x0xb0x/x0xb0x.github.io/README.md

# x0xb0x.github.io
Please view on [http://x0xb0x.github.io](http://x0xb0x.github.io)

All info licensed CC-BY, all software licenced MIT.
