x0xb0x/x0xb0x.github.io/assets/images/betameter.gif

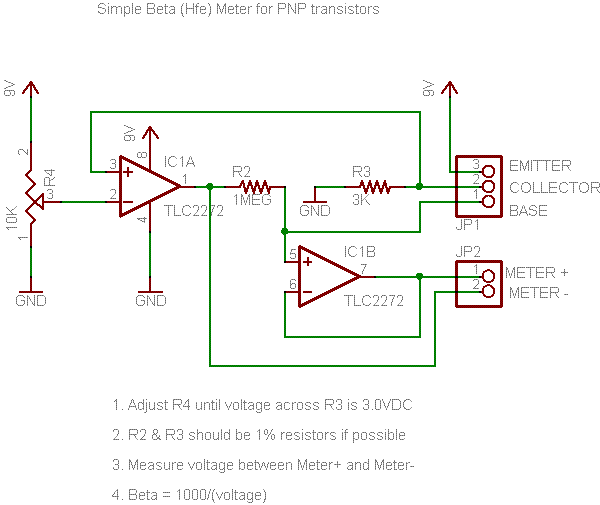
assets/images/betameter.gif
