x0xb0x/x0xb0x.github.io/assets/images/diytools/aps1.jpg

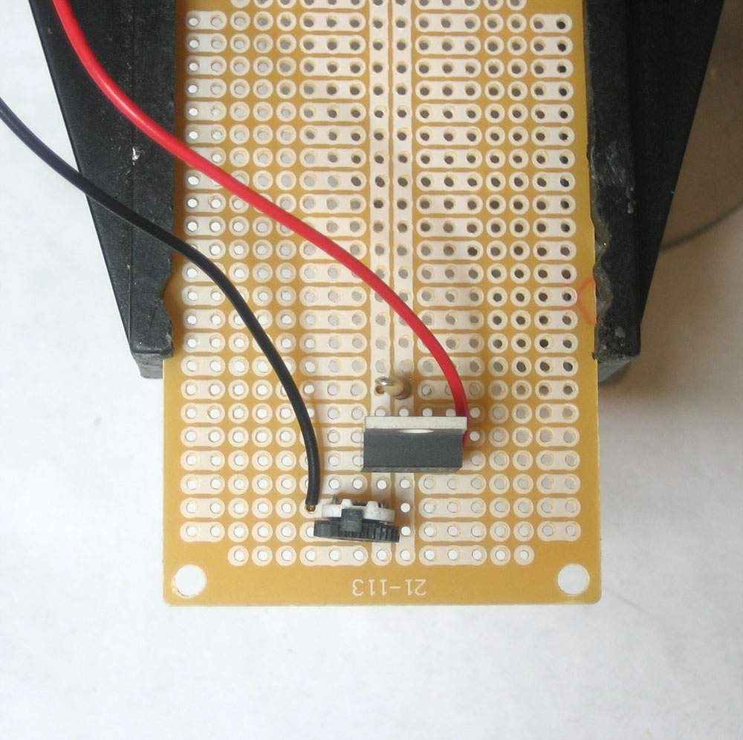
assets/images/diytools/aps1.jpg
