x0xb0x/x0xb0x.github.io/assets/images/diytools/apsparts.jpg

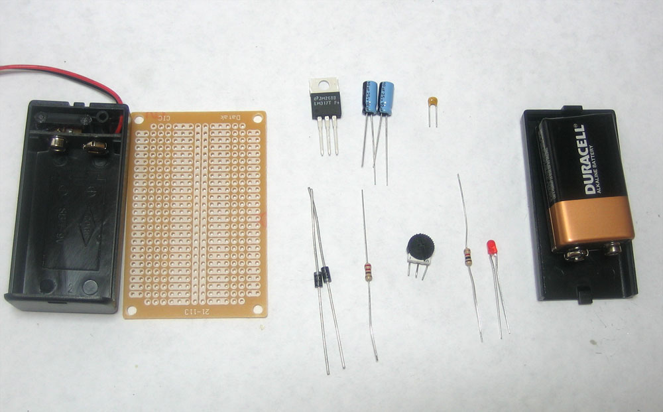
assets/images/diytools/apsparts.jpg
