x0xb0x/x0xb0x.github.io/assets/images/diytools/bandgaptest.jpg

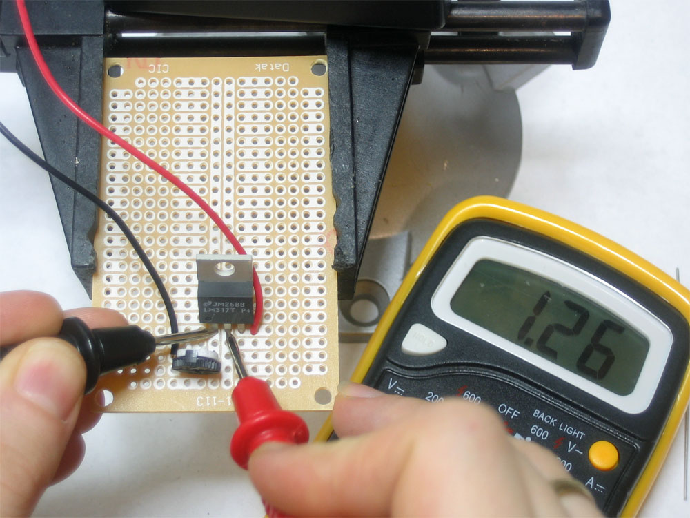
assets/images/diytools/bandgaptest.jpg
