x0xb0x/x0xb0x.github.io/assets/images/diytools/CA-2208.jpg

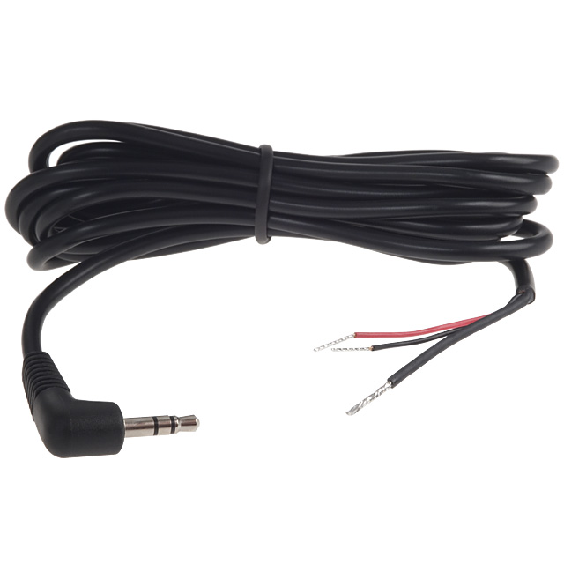
assets/images/diytools/CA-2208.jpg
