x0xb0x/x0xb0x.github.io/assets/images/diytools/done.jpg

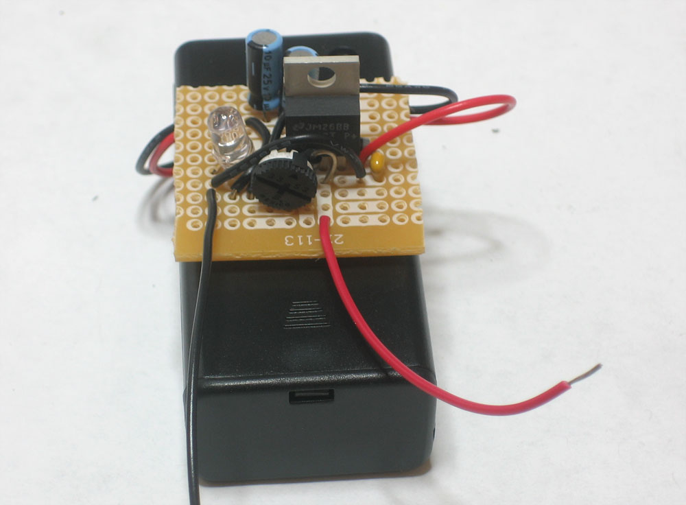
assets/images/diytools/done.jpg
