x0xb0x/x0xb0x.github.io/assets/images/diytools/highout.jpg

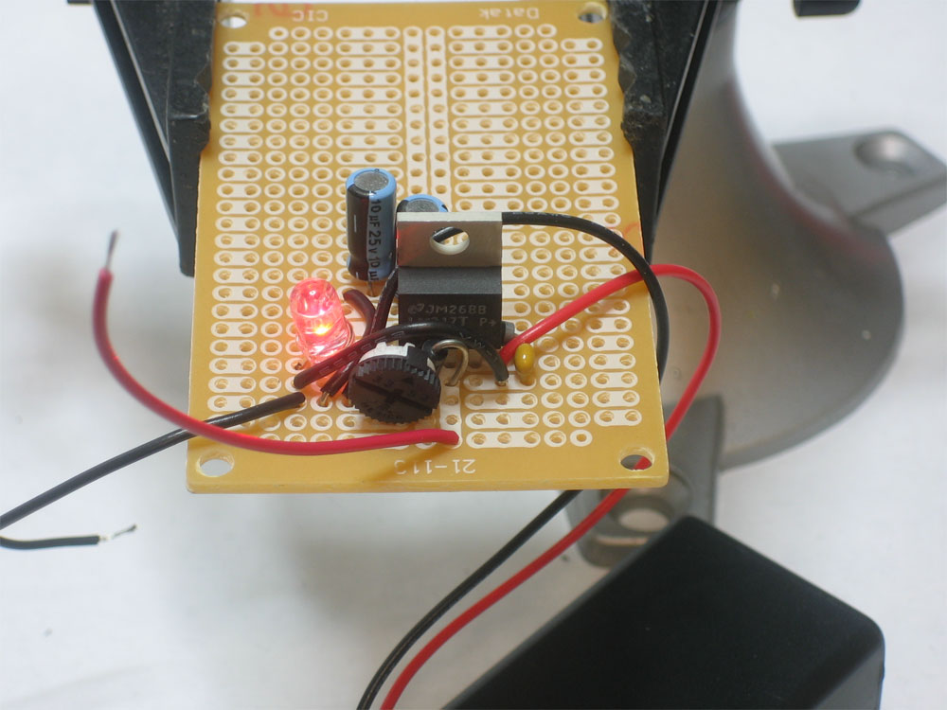
assets/images/diytools/highout.jpg
