x0xb0x/x0xb0x.github.io/assets/images/diytools/lowout.jpg

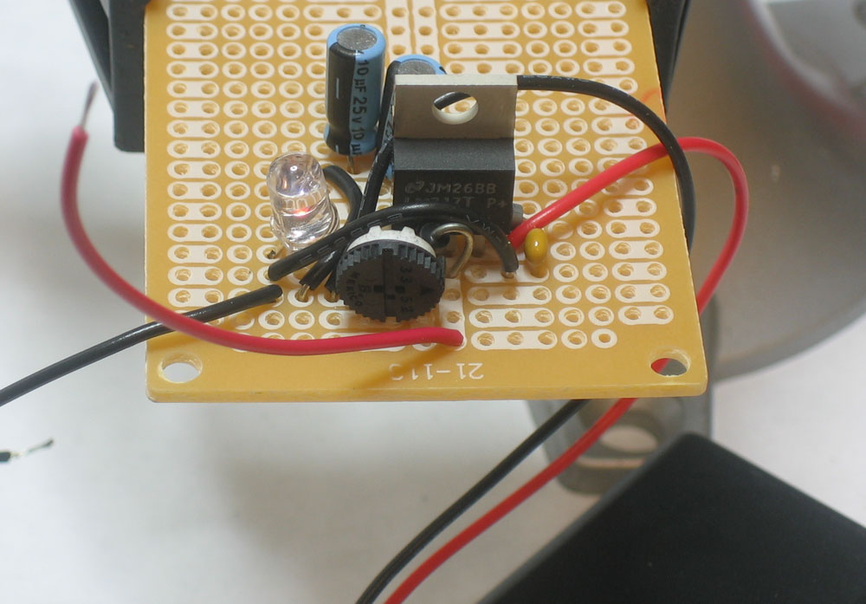
assets/images/diytools/lowout.jpg
