x0xb0x/x0xb0x.github.io/assets/images/diytools/outtest2.jpg

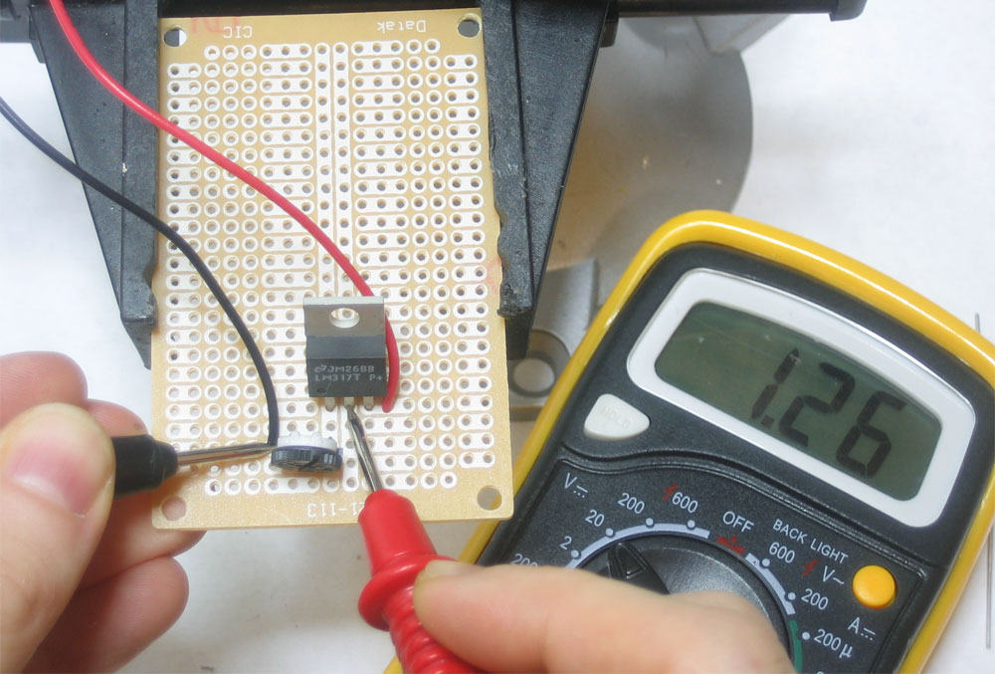
assets/images/diytools/outtest2.jpg
