x0xb0x/x0xb0x.github.io/assets/images/diytools/probe1.jpg

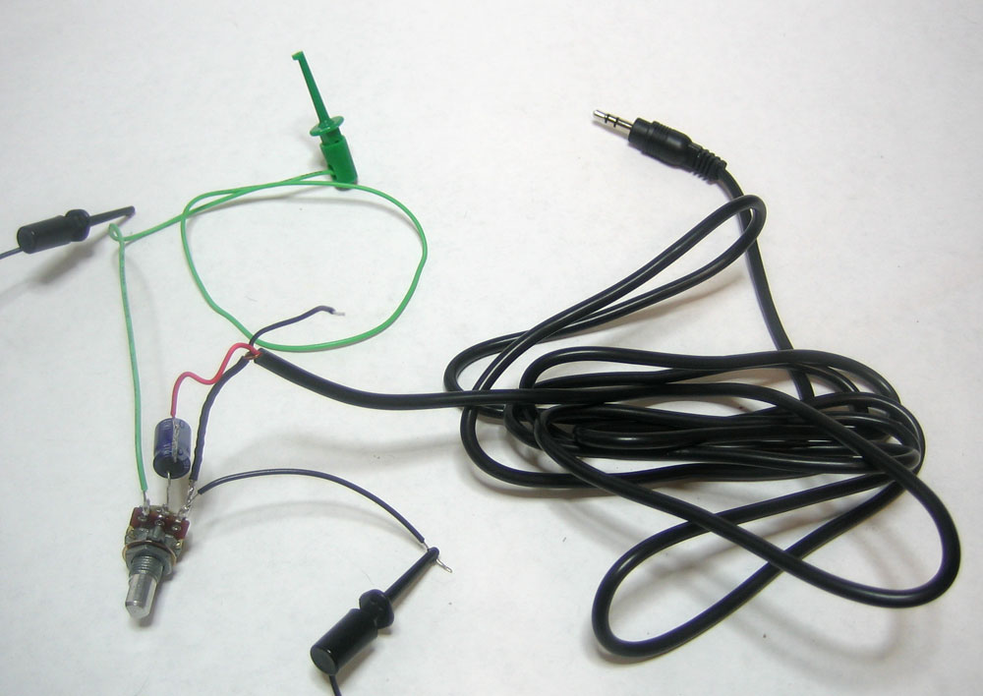
assets/images/diytools/probe1.jpg
