x0xb0x/x0xb0x.github.io/assets/images/diytools/probe2.jpg

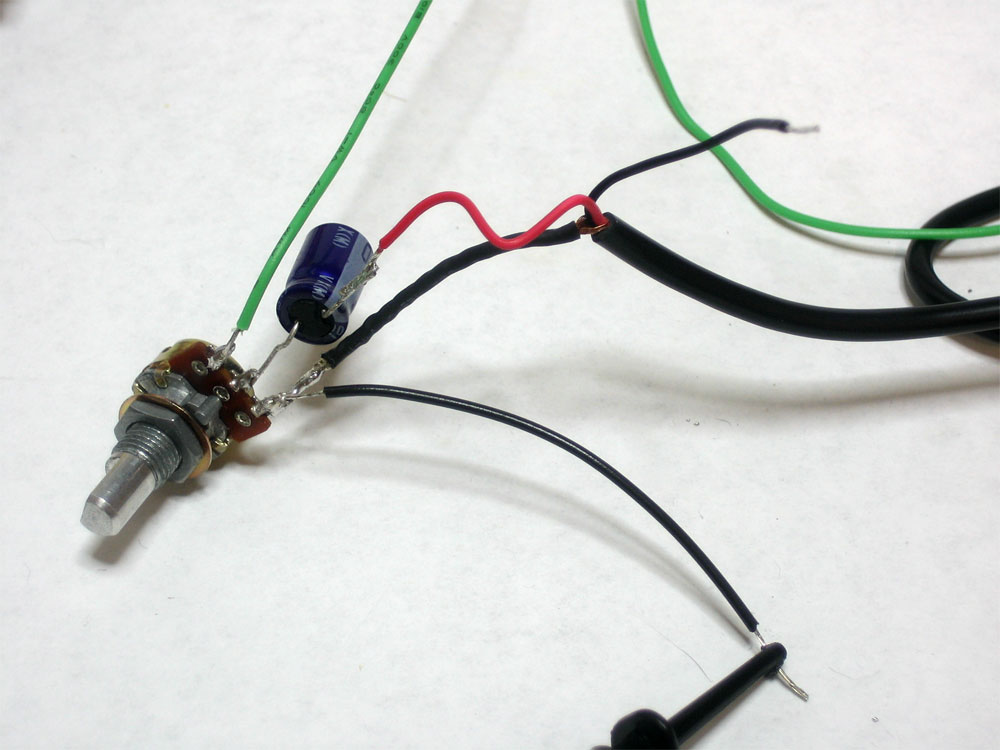
assets/images/diytools/probe2.jpg
