x0xb0x/x0xb0x.github.io/assets/images/diytools/schem.jpg

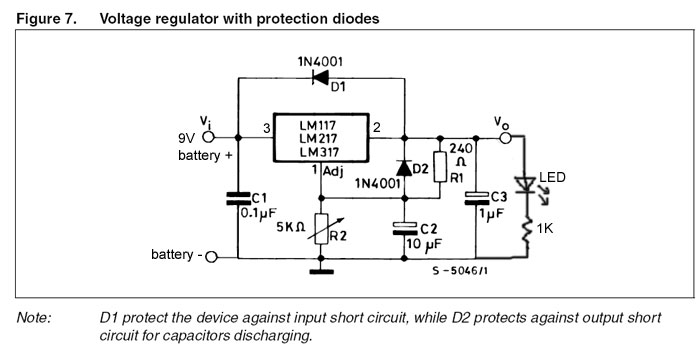
assets/images/diytools/schem.jpg
