x0xb0x/x0xb0x.github.io/assets/images/tools/100ftsolid_t.jpg

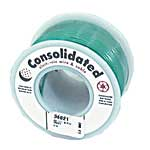
assets/images/tools/100ftsolid_t.jpg
