x0xb0x/x0xb0x.github.io/assets/images/tools/bantest_t.jpg

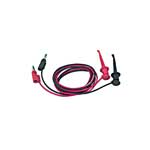
assets/images/tools/bantest_t.jpg
