x0xb0x/x0xb0x.github.io/assets/images/tools/bkprecision_875b.jpg

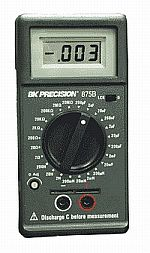
assets/images/tools/bkprecision_875b.jpg
