x0xb0x/x0xb0x.github.io/assets/images/tools/dialcalipers_t.jpg

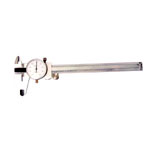
assets/images/tools/dialcalipers_t.jpg
