x0xb0x/x0xb0x.github.io/assets/images/tools/esdtweezers_t.jpg

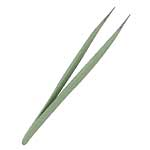
assets/images/tools/esdtweezers_t.jpg
