x0xb0x/x0xb0x.github.io/assets/images/tools/flush.jpg

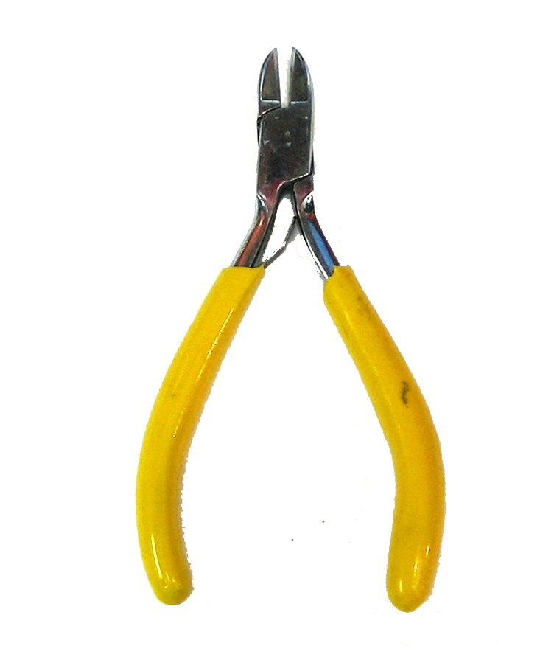
assets/images/tools/flush.jpg
