x0xb0x/x0xb0x.github.io/assets/images/tools/heatgun_t.jpg

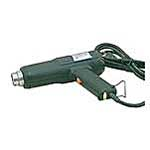
assets/images/tools/heatgun_t.jpg
