x0xb0x/x0xb0x.github.io/assets/images/tools/heatgunattach_t.jpg

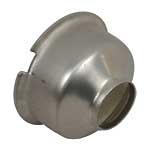
assets/images/tools/heatgunattach_t.jpg
