x0xb0x/x0xb0x.github.io/assets/images/tools/HFshear_t.gif

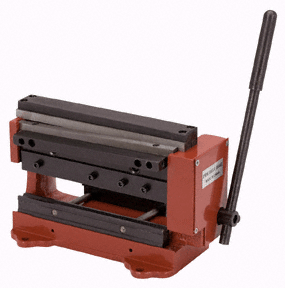
assets/images/tools/HFshear_t.gif
