x0xb0x/x0xb0x.github.io/assets/images/tools/icextractor.jpg

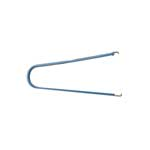
assets/images/tools/icextractor.jpg
