x0xb0x/x0xb0x.github.io/assets/images/tools/metcal200sp.jpg

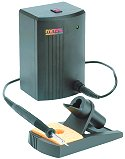
assets/images/tools/metcal200sp.jpg
