x0xb0x/x0xb0x.github.io/assets/images/tools/metcalmx500.jpg

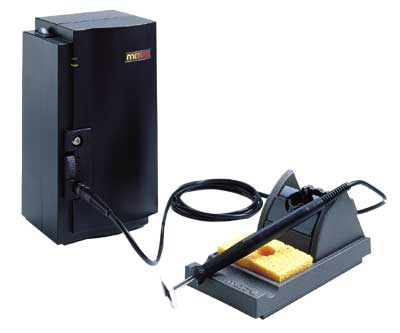
assets/images/tools/metcalmx500.jpg
