x0xb0x/x0xb0x.github.io/assets/images/tools/meter.jpg

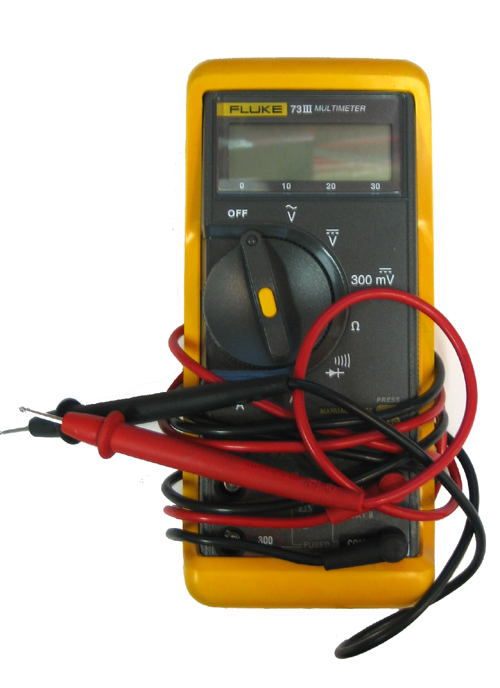
assets/images/tools/meter.jpg
