x0xb0x/x0xb0x.github.io/assets/images/tools/needlenose.jpg

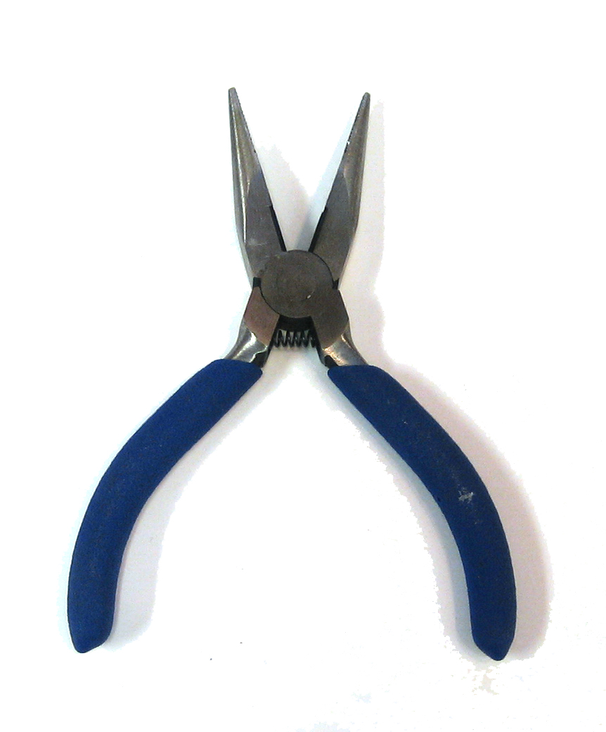
assets/images/tools/needlenose.jpg
