x0xb0x/x0xb0x.github.io/assets/images/tools/nibbler_t.jpg

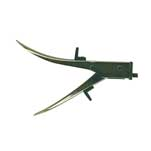
assets/images/tools/nibbler_t.jpg
