x0xb0x/x0xb0x.github.io/assets/images/tools/sucker.jpg

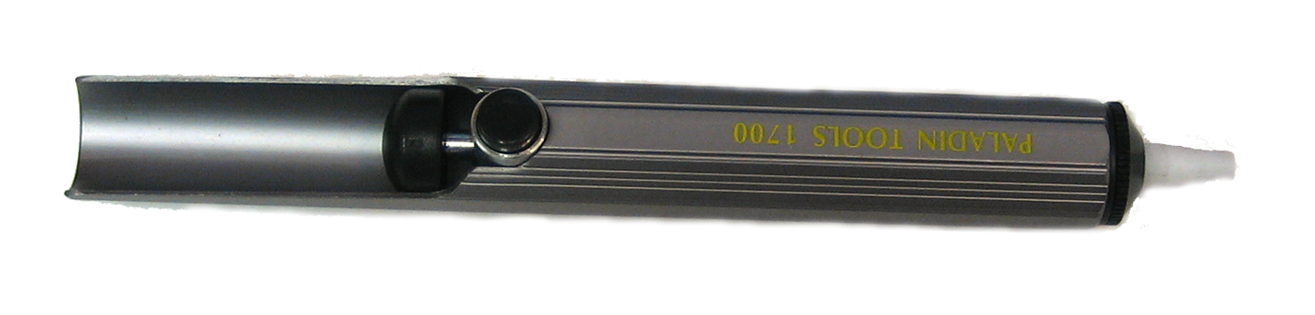
assets/images/tools/sucker.jpg
