x0xb0x/x0xb0x.github.io/assets/images/tools/tiptin_t.jpg

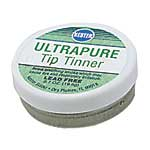
assets/images/tools/tiptin_t.jpg
