x0xb0x/x0xb0x.github.io/assets/images/tools/ttechshear.jpg

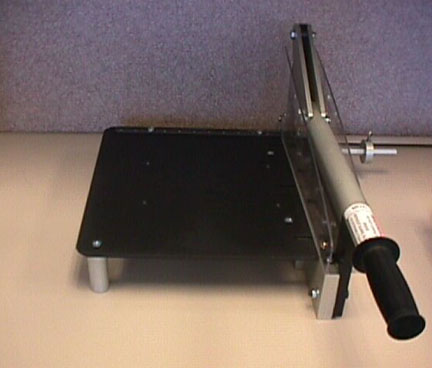
assets/images/tools/ttechshear.jpg
