x0xb0x/x0xb0x.github.io/assets/images/tools/tweezers.jpg

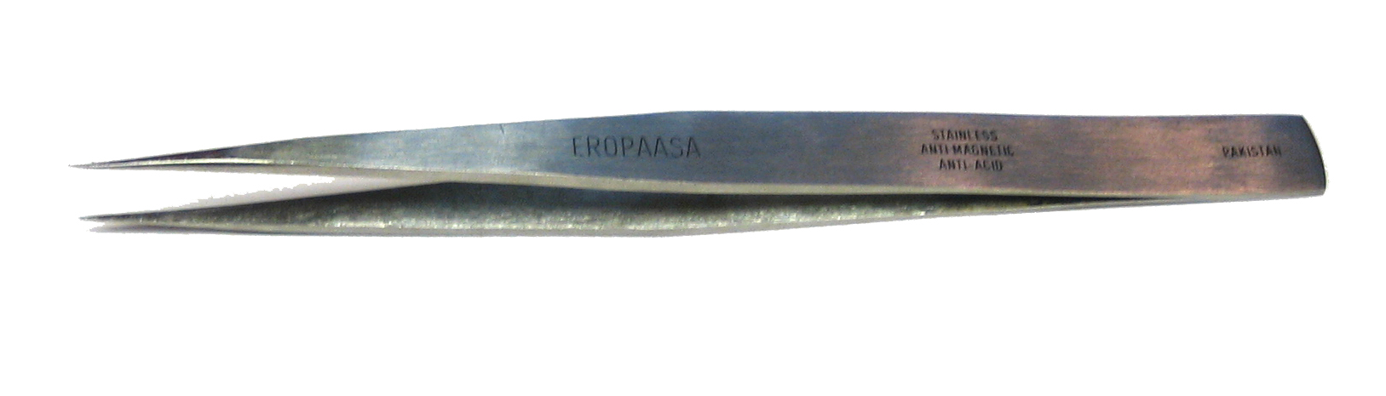
assets/images/tools/tweezers.jpg
