x0xb0x/x0xb0x.github.io/assets/images/tools/univcrimp_t.jpg

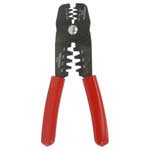
assets/images/tools/univcrimp_t.jpg
