x0xb0x/x0xb0x.github.io/assets/images/tools/wihaprecscrewdriverset_t.jpg

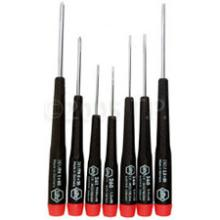
assets/images/tools/wihaprecscrewdriverset_t.jpg
