x0xb0x/x0xb0x.github.io/assets/images/tools/wirecutterstripper_t.jpg

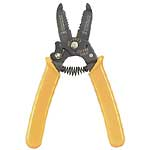
assets/images/tools/wirecutterstripper_t.jpg
