x0xb0x/x0xb0x.github.io/assets/images/tools/xytronics.jpg

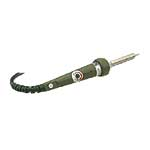
assets/images/tools/xytronics.jpg
