x0xb0x/x0xb0x.github.io/assets/images/x0xb0x/fab/ps/53adjustmax.jpg

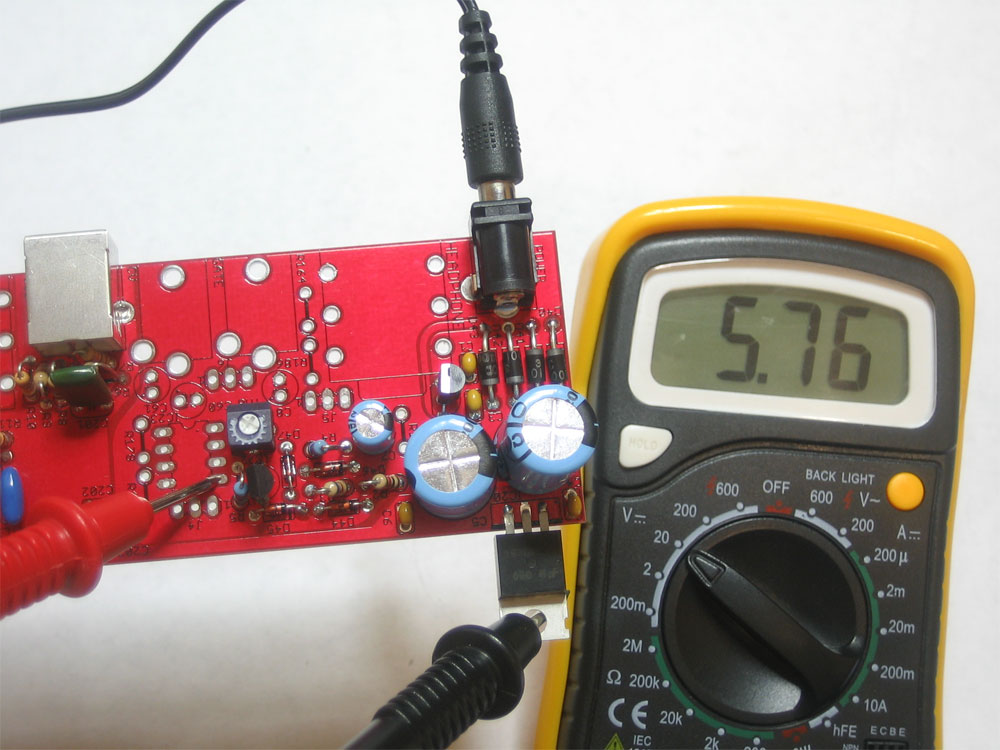
assets/images/x0xb0x/fab/ps/53adjustmax.jpg
