x0xb0x/x0xb0x.github.io/assets/images/x0xb0x/fab/ps/finalplace.jpg

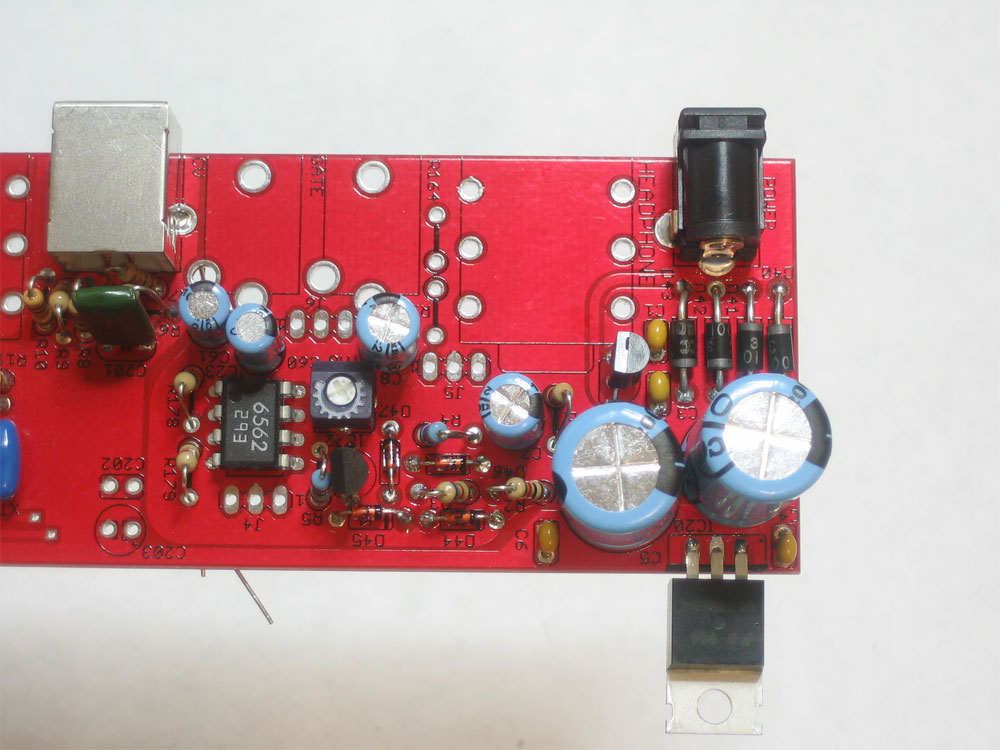
assets/images/x0xb0x/fab/ps/finalplace.jpg
