x0xb0x/x0xb0x.github.io/assets/images/x0xb0x/fab/vco/cvtest.jpg

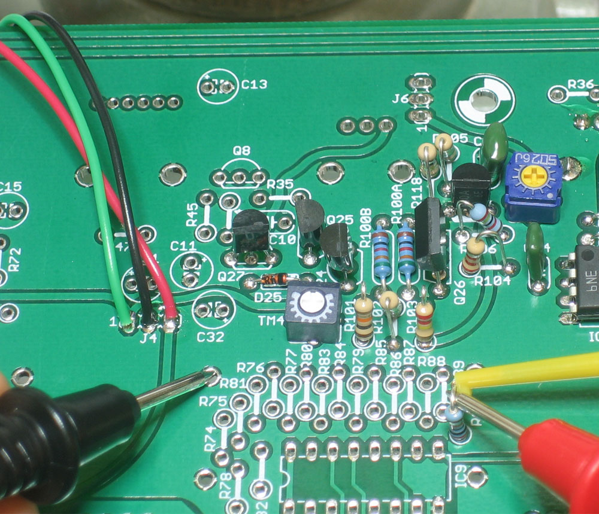
assets/images/x0xb0x/fab/vco/cvtest.jpg
