x0xb0x/x0xb0x.github.io/assets/images/x0xb0x/fab/vco/ready.jpg

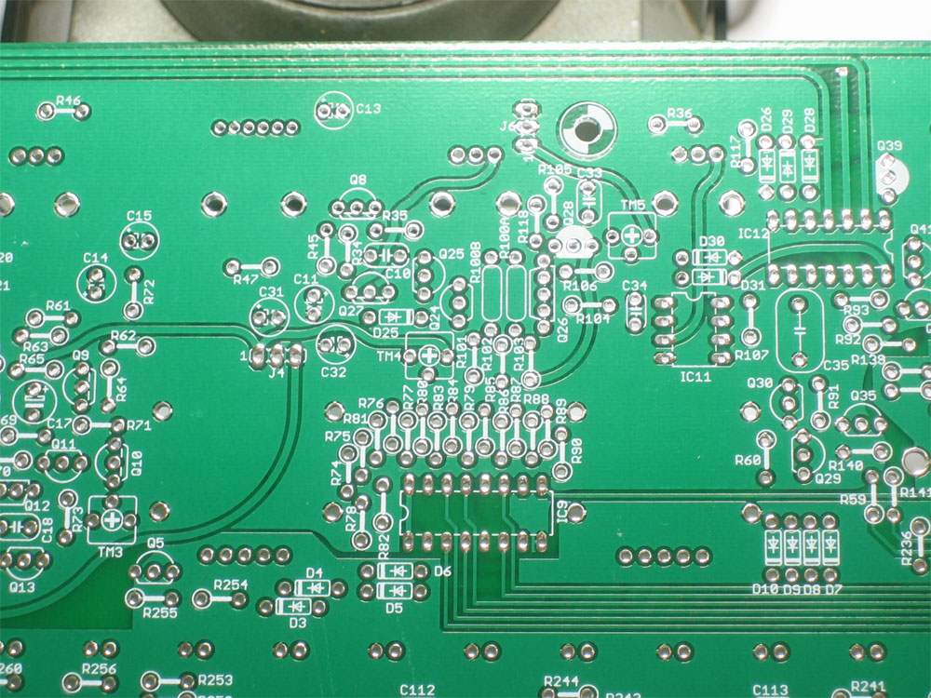
assets/images/x0xb0x/fab/vco/ready.jpg
