x0xb0x/x0xb0x.github.io/assets/images/x0xb0x/fab/vco/squaremeter.jpg

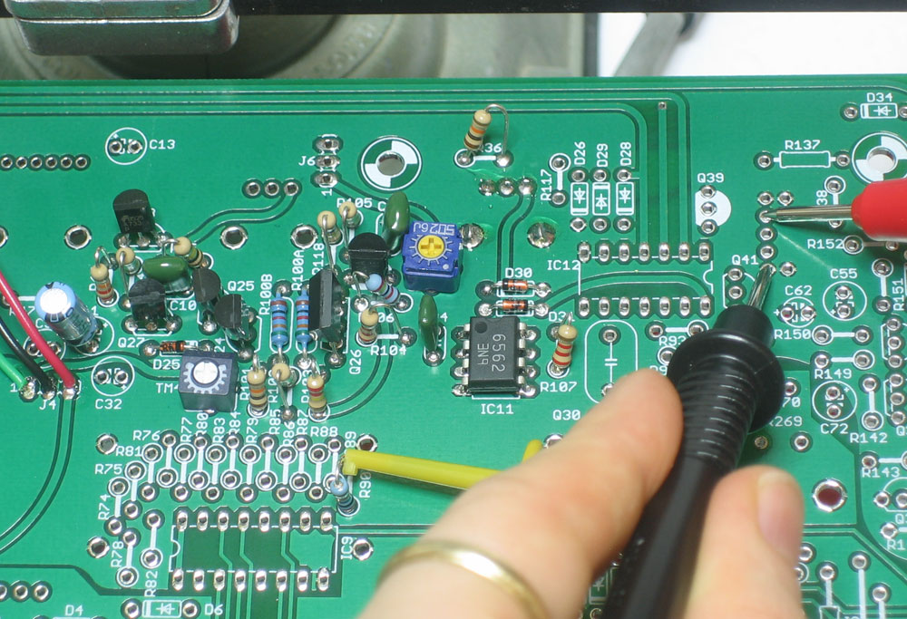
assets/images/x0xb0x/fab/vco/squaremeter.jpg
