x0xb0x/x0xb0x.github.io/assets/images/x0xb0x/fab/vco/vco1side.jpg

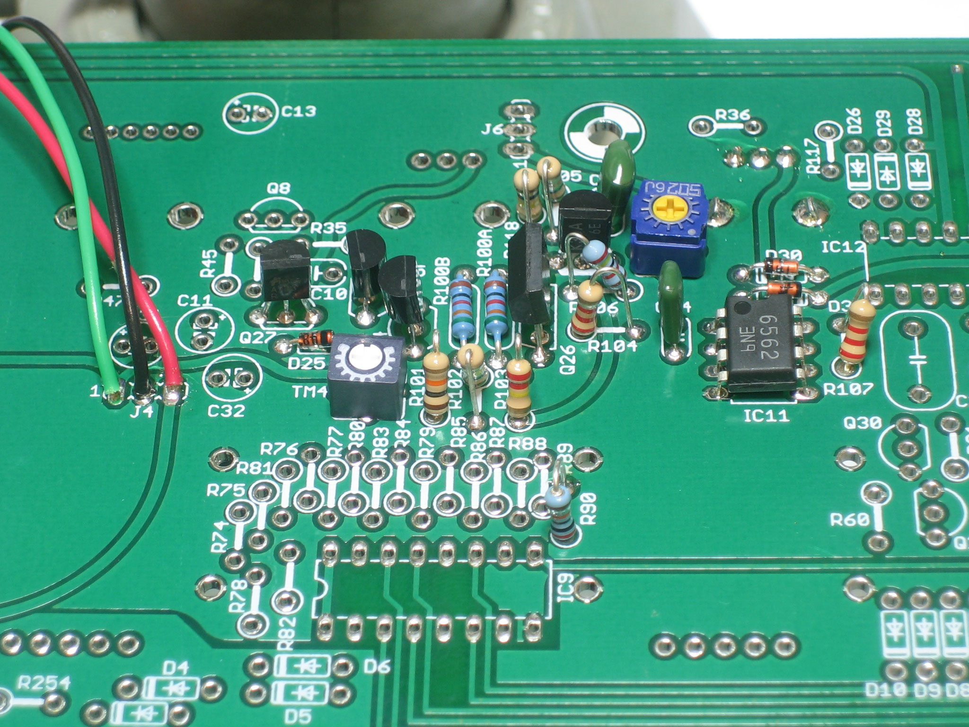
assets/images/x0xb0x/fab/vco/vco1side.jpg
