x0xb0x/x0xb0x.github.io/assets/images/x0xb0x/gallery/x0x515-3.jpg

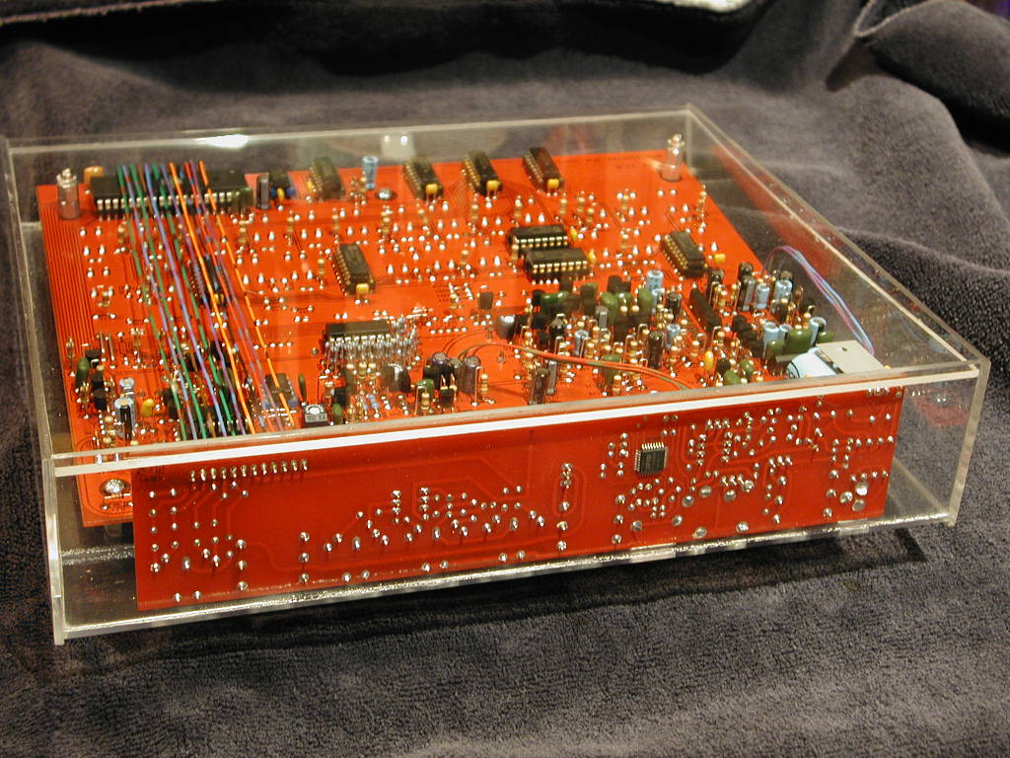
assets/images/x0xb0x/gallery/x0x515-3.jpg
