x0xb0x/x0xb0x.github.io/assets/images/x0xb0x/shorts.jpg

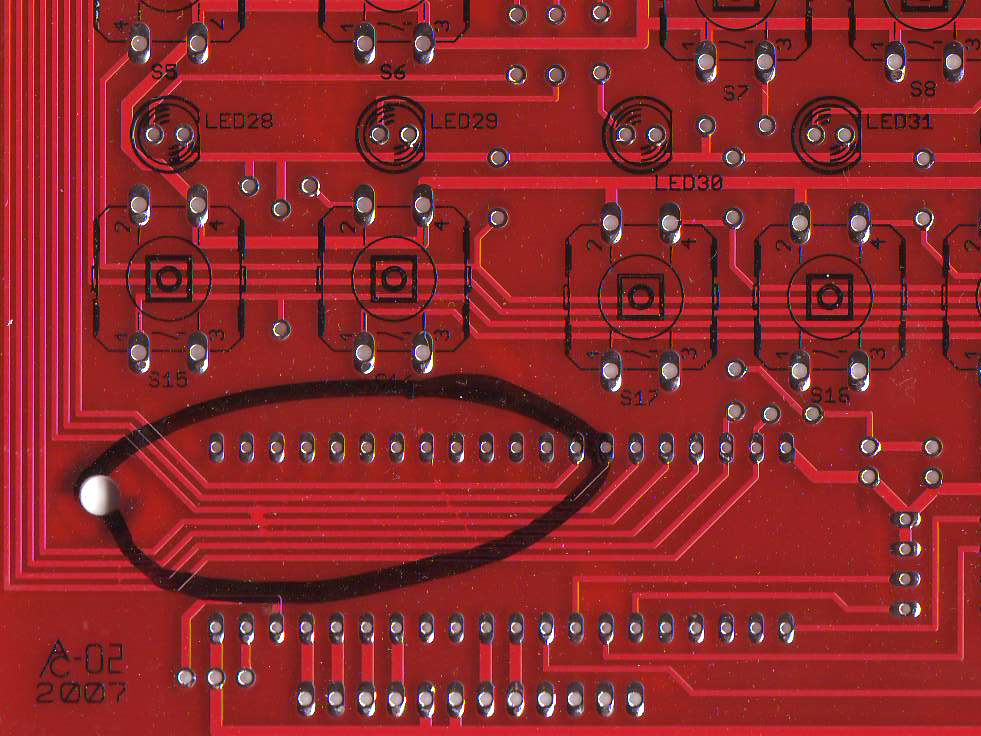
assets/images/x0xb0x/shorts.jpg
