x0xb0x/x0xb0x.github.io/assets/media/x0xb0x/ioboard release v1_0.png

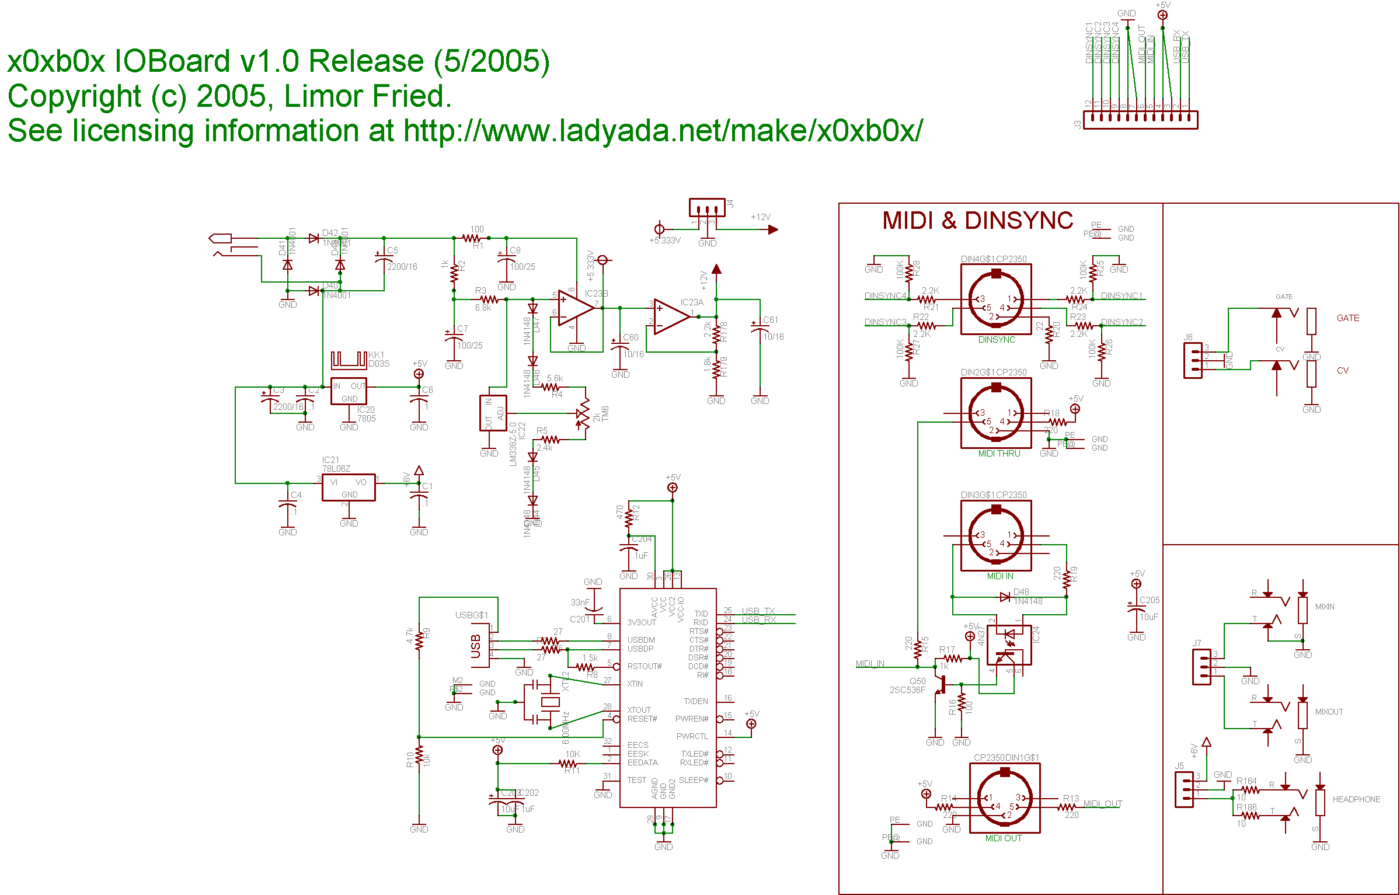
assets/media/x0xb0x/ioboard release v1_0.png
