x0xb0x/x0xb0x.github.io/assets/media/x0xb0x/mainboard_beta.png

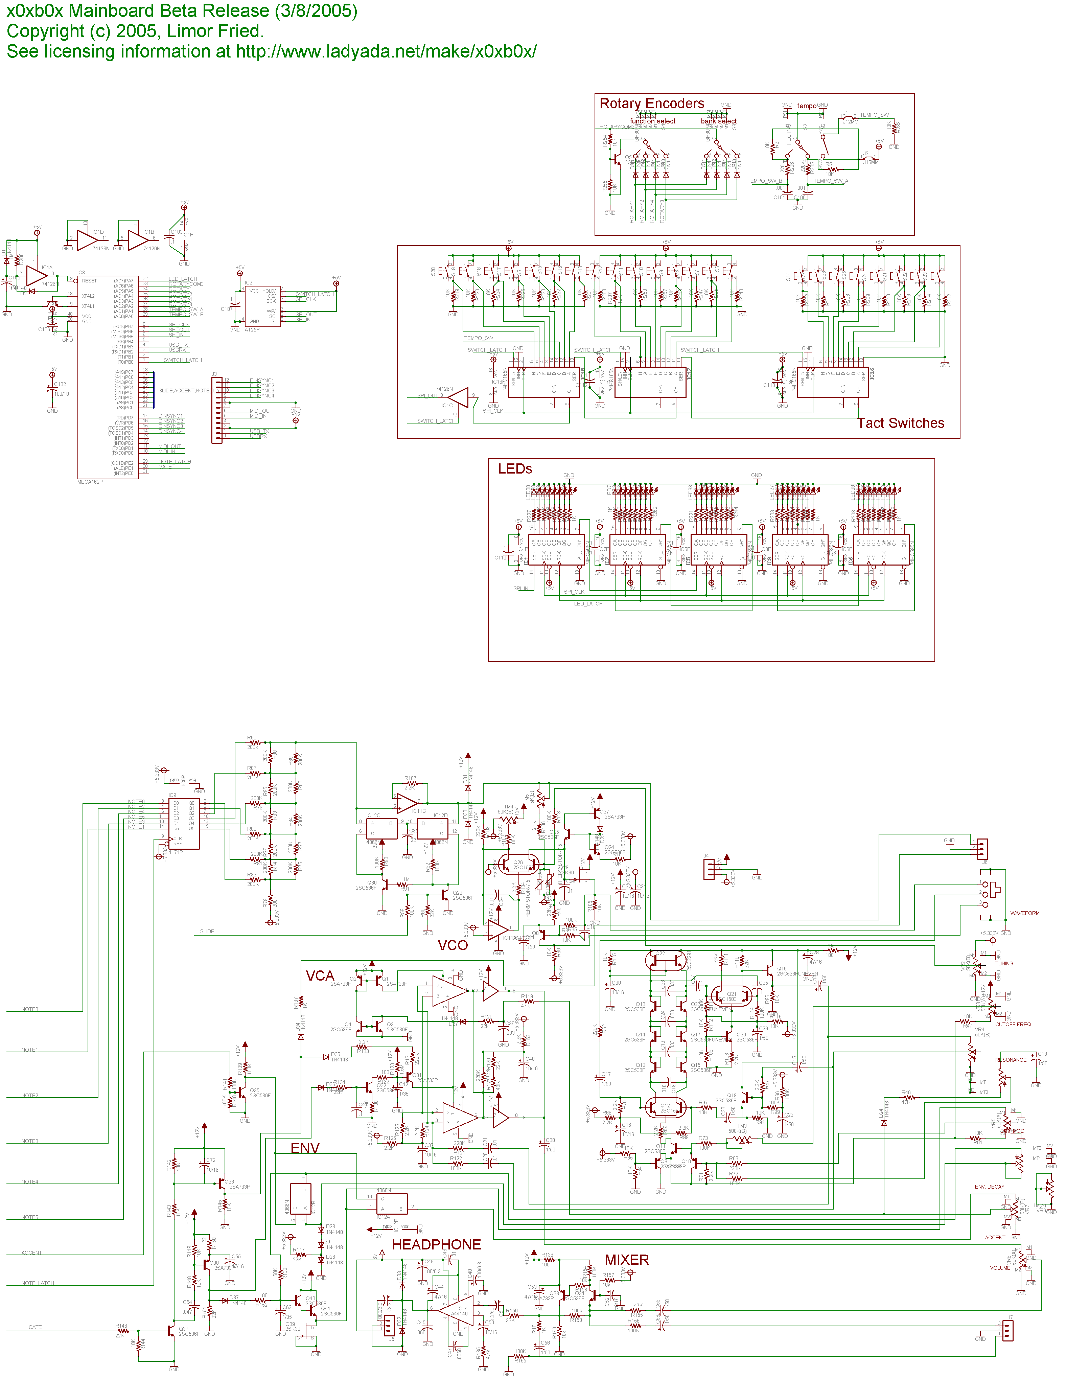
assets/media/x0xb0x/mainboard_beta.png
