x0xb0x/x0xb0x.github.io/pages/ladyada.net/make/x0xb0x/fab/parts.html

Image | Description | Qty | Manufacturer & Datasheet | Distributor
 | ABS Case | 1 | Pactec PT-10 (http://www.pactecenclosures.com/Plastic-Enclosures/PT-10.html) | PacTec (http://www.pactecenclosures.com/)
 | Set of main and I/O panels | 1 | Custom | Adafruit (http://www.adafruit.com/)
 | Set of main and I/O PCBs | 1 | Custom | Adafruit (http://www.adafruit.com/)
 | ATmega162 microcontroller IC3 | 1 | Atmega162-16PU | Digikey (http://www.digikey.com/scripts/DkSearch/dksus.dll?PName?Name=ATMEGA162-16PU-ND&Site=US) Mouser (http://www.mouser.com/search/ProductDetail.aspx) For programmed version, Adafruit (http://www.adafruit.com/)
 | 9VAC 300-500mA wall wart 2.1mm barrel adaptor. | 1 | Generic | Jameco (http://www.jameco.com/webapp/wcs/stores/servlet/ProductDisplay?productId=226131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) Farnell (http://uk.farnell.com/jsp/Electrical/Power+Supplies+&+Converters/UNBRANDED/AC-0930/displayProduct.jsp?sku=4264976) (9VAC 300mA UK) Farnell (http://uk.farnell.com/jsp/Electrical/Power+Supplies+&+Converters/UNBRANDED/AC-0960/displayProduct.jsp?sku=1176239) (9VAC 600mA UK) Farnell (http://uk.farnell.com/jsp/Electrical/Power+Supplies+&+Converters/UNBRANDED/MB090A050U/D/displayProduct.jsp?sku=1217064) (9VAC 500mA Euro)
 | x0xb0x serial tag | 1 |  | Only with purchased kits
Image | Description | Part number | Qty | Manufacturer & Datasheet | Distributor
 | 2SA733P TO-92 PNP transistor | Q1* Q2* Q8 Q9 Q10 Q27 Q31 Q33 Q36 Q38 | 10 | Fairchild 2SA733P | Mouser (http://www.mouser.com/search/ProductDetail.aspx?R=2SA733Pvirtualkey51210000virtualkey512-2SA733P)
 | 2SC536F TO-92 NPN transistor These will have "536F" somewhere on the body | Q3* Q4* Q5 Q11 Q13 Q23 Q14 Q15 Q16 Q17 Q18 Q19 Q20 Q24 Q25 Q29 Q30 Q32 Q34 Q35 Q37 Q40 Q41 Q50 | 24 | Rare (http://www.ladyada.net/wiki/x0x/rareparts)
 | 2SK30 JFET Some kits have a 2SK30AY and a 2SK30AO, see the instructions for which one to put where. | Q28 Q39 | 2 | Rare (http://www.ladyada.net/wiki/x0x/rareparts)
 | 2SC2291 5-SIP matched pair with common base | Q22 | 1 | Rare (http://www.ladyada.net/wiki/x0x/rareparts)
 | 2SC1583 5-SIP matched pair with common emitter | Q12 Q21 Q26 | 3 | Rare (http://www.ladyada.net/wiki/x0x/rareparts)
 | LA4140 9-SIP Headphone amplifier | IC14 | 1 | Rare (http://www.ladyada.net/wiki/x0x/rareparts)
 | BA6110 (9-SIP) Operational Transconductance Amplifier | IC15B* | 1 | Rare (http://www.ladyada.net/wiki/x0x/rareparts)
 | BA662A (9-SIP) Operational Transconductance Amplifier | IC15A* | (optional, not included) | Extremely rare (http://www.ladyada.net/wiki/x0x/rareparts)
 | 7805 (TO-220) 5V, 1A voltage regulator | IC20 | 1 | 78M05 | Mouser (http://www.mouser.com/search/ProductDetail.aspx Digikey (http://www.digikey.com/scripts/DkSearch/dksus.dll?Detail?name=NJM%2378M05FA-ND) Nearly any distributor
 | 7806 (TO-92) 6V 100mA voltage regulator | IC21 | 1 | 78L06 | Mouser (http://www.mouser.com/search/ProductDetail.aspx Digikey (http://www.digikey.com/scripts/DkSearch/dksus.dll?Detail?name=MC78L06BP-APMSCT-ND)
 | LM336Z-5.0 (TO-92) 5V precision voltage reference | IC22 | 1 | LM336Z-5.0 (http://www.mouser.com/search/ProductDetail.aspx | Digikey Mouser (http://www.mouser.com/search/ProductDetail.aspx
 | FT232 USB chip | IC25 | 1 | FT232BM | Mouser (http://www.mouser.com/search/ProductDetail.aspx?R=FT232BMvirtualkey62130000virtualkey895-FT232BM)
 | 6MHz ceramic resonator Might be orange colored | XTAL2 | 1 | Abracon AWCR-6.00MD (Or any 6.0 MHz ceramic resonator) | Mouser (http://www.mouser.com/search/ProductDetail.aspx) Digikey (http://www.digikey.com/scripts/DkSearch/dksus.dll?Detail?name=X904-ND)
 | 16MHz ceramic resonator | XTAL1 | 1 | Abracon AWCR-16.00MD | Mouser (http://www.mouser.com/search/ProductDetail.aspx) Digikey (http://www.digikey.com/scripts/DkSearch/dksus.dll?Detail?name=X908-ND)
 | 1N4001 Input voltage doubling | D40, D41, D42, D43 | 4 | Generic 1N4001 | Digikey (http://www.digikey.com/scripts/DkSearch/dksus.dll?Detail?name=1N4001FSCT-ND) Mouser (http://www.mouser.com/search/ProductDetail.aspx?R=1N4001-Bvirtualkey58300000virtualkey583-1N4001-B) Nearly any distributor
 | 1N4148 | D1 D2 D3 D4 D5 D6 D7 D8 D9 D10 D25 D26 D28 D29 D30 D31 D44 D45 D46 D47 D48 D24 D27 D35 D36 D32 D33 D34 D37 | 29 | Generic 1N4148 | Mouser (http://www.mouser.com/search/ProductDetail.aspx?R=1N4148-TRvirtualkey61350000virtualkey78-1N4148) Digikey (http://www.digikey.com/scripts/DkSearch/dksus.dll?Detail?name=1N4148FS-ND) Nearly any distributor
Image | Description | Part number | Qty | Manufacturer & Datasheet | Distributor
 | Red 5mm LED | LED1-LED40 | 40 | Generic
 | 0.24" LED standoff Other LEDs may require different sizes | LED1*-LED40* | 40 | VCC STD240B | Mouser (http://www.mouser.com/search/ProductDetail.aspx?R=STD240BLKvirtualkey59300000virtualkey593-STD240B)
Image | Description | Part number | Qty | Manufacturer & Datasheet | Distributor
 | AN6562 8-DIP dual Op-Amp | IC11, IC23 | 2 | Rare (http://www.ladyada.net/wiki/x0x/rareparts)
 | 4066 analog switch Has "4066" somewhere on the body | IC12 | 1 | Generic | Digikey (http://www.digikey.com/scripts/DkSearch/dksus.dll?Detail?name=296-2061-5-ND) Mouser (http://www.mouser.com/search/ProductDetail.aspx?R=HCF4066BEYvirtualkey51120000virtualkey511-4066)
 | 74HC174 or 74AC174 Has "174" somewhere on the body | IC9 | 1 | Generic | Digikey (http://www.digikey.com/scripts/DkSearch/dksus.dll?Detail?name=296-4236-5-ND) Mouser (http://www.mouser.com/search/ProductDetail.aspx
 | 74HC126 Has "126" somewhere on the body | IC1 | 1 | Generic (http://focus.ti.com/docs/prod/folders/print/cd74hc126.html) | Digikey (http://www.digikey.com/scripts/DkSearch/dksus.dll?Detail?name=296-8221-5-ND) Mouser (http://www.mouser.com/search/ProductDetail.aspx)
(image soon!) | 74AC165 or 74HC165 Has "165" somewhere on the body | IC16 IC17 IC18 | 3 | Generic (http://focus.ti.com/general/docs/lit/getliterature.tsp?genericPartNumber=CD74HC165) | Digikey (http://www.digikey.com/scripts/DkSearch/dksus.dll?Detail?name=296-8251-5-ND) Mouser (http://www.mouser.com/search/ProductDetail.aspx)
 | 74HC595 Has "595" somewhere on the body | IC4 IC5 IC6 IC7 IC8 | 5 | Generic (http://focus.ti.com/general/docs/lit/getliterature.tsp?genericPartNumber=SN74HC595) | Digikey (http://www.digikey.com/scripts/DkSearch/dksus.dll?Detail?name=568-1484-5-ND) Mouser (http://www.mouser.com/Search/ProductDetail.aspx)
 | 4N37 optoisolator Might be white-colored | IC24 | 1 | Generic | Mouser (http://www.mouser.com/search/ProductDetail.aspx?R=4N37Mvirtualkey51210000virtualkey512-4N37M) Digikey (http://www.digikey.com/scripts/DkSearch/dksus.dll?Detail?name=160-1306-5-ND)
 | 25C33 or AT25320 32Kb (4KB) EEPROM May be named something else, look for "25" and "320" or "33" or "32" on the body | IC2 | 1 | CAT2532 (http://www.onsemi.com/PowerSolutions/content.do?id=16700) | Digikey (http://www.digikey.com/scripts/DkSearch/dksus.dll?Detail?name=CAT25320LI-G-ND) Mouser (http://www.mouser.com/search/ProductDetail.aspx)
Image | Description | Part number | Qty | Manufacturer & Datasheet | Distributor
 | Heat sink (TO-220) | IC20' | 1 | Aavid 574502B00000G (http://www.aavidthermalloy.com/cgi-bin/stdisp_print.pl?Pnum=574502b00000) | Mouser (http://www.mouser.com/search/ProductDetail.aspx) Digikey (http://www.digikey.com/scripts/DkSearch/dksus.dll?PName?Name=HS198-ND&Site=US) Allied (http://alliedelec.com/Search/ProductDetail.asp?SKU=619-0154&MPN=574502B00000G)
 | 40-pin DIP socket | IC3' | 1 | AMP 390262-5 (http://catalog.tycoelectronics.com/TE/bin/TE.Connect?C=1&M=BYPN&PN=390262-5&I=13) (Any 40 pin socket will do) | Mouser (http://www.mouser.com/search/ProductDetail.aspx?R=390262-5virtualkey57100000virtualkey571-3902625)
 | 8-pin DIP socket | IC2* | 1 | AMP 390261-2 (http://catalog.tycoelectronics.com/TE/bin/TE.Connect?C=1&M=BYPN&PN=390261-2&I=13) (Any 8 pin socket will do) | Mouser (http://www.mouser.com/search/ProductDetail.aspx?R=390261-2virtualkey57100000virtualkey571-3902612)
 | 1/4" stereo jack | MIXOUT MIXIN HEADPHONE | 3 | Neutrik NYS216 (http://www.neutrik.com/content/products/detail.aspx?id=210_980737404&catId=CatMSDE_audio) | Mouser (http://www.mouser.com/search/ProductDetail.aspx?R=NYS216virtualkey56810000virtualkey568-NYS216) Allied (http://alliedelec.com/Search/ProductDetail.asp?SKU=514-8640&MPN=NYS216)
 | 1/8" jack | CV GATE | 2 | CUI MJ-CP3536N (http://www.cui.com/catalog/resource/pdf/product/resource/pdf) | Digikey (http://www.digikey.com/scripts/DkSearch/dksus.dll?Detail?name=CP-3536N-ND)
 | 2.1mm power jack Power input | POWER | 1 | CUI PJ-202AH (http://www.cui.com/catalog/resource/pdf/product/resource/pdf) | Digikey (http://www.digikey.com/scripts/DkSearch/dksus.dll?Detail?name=CP-202AH-ND)
 | USB type-B jack USB communication | USB | 1 | Kobiconn 154-2442-E (Any USB type-B through hole jack is OK) | Mouser (http://www.mouser.com/search/ProductDetail.aspx?R=154-2442-Evirtualkey11180000virtualkey154-2442-E)
 | MIDI/DINSYNC jack MIDI In/Out/Thru and DINSYNC | DIN1 DIN2 DIN3 DIN4 | 4 | CUI SDS-50J (http://www.cui.com/catalog/resource/pdf/product/resource/pdf) (Nearly any MIDI jack is OK as long as the front pins match) | Digikey (http://www.digikey.com/scripts/DkSearch/dksus.dll?Detail?name=CP-2350-ND)
 | Toggle switch Waveform saw/square selection | SW1 | 1 | NKK B12AB-RO | Mouser (http://www.mouser.com/search/ProductDetail.aspx?R=B12AB-ROvirtualkey63300000virtualkey633-B12AB-RO)
 | Rotary encoder Tempo adjustment | S2 | 1 | CTS 290VAA5F201B2 | Digikey (http://www.digikey.com/scripts/DkSearch/dksus.dll?Detail?name=CT3011-ND)
 | 16 position rotary switch Bank and Mode selection | S3 S4 | 2 | Grayhill 25LB22-H | Digikey (http://www.digikey.com/scripts/DkSearch/dksus.dll?Detail?name=GH3074-ND) Newark (http://www.newark.com/jsp/displayProduct.jsp?sku=16F7295)
 | Tact switch For keyboard switches | S5 S6 S7 S8 S9 S10 S11 S12 S13 S14 S15 S16 S17 S18 S19 S20 S21 S22 S23 S24 S25 S26 S27 | 23 | E-Switch TL1100F160Q "standard 12mm tact switch" | Digikey (http://www.digikey.com/scripts/DkSearch/dksus.dll?Detail?name=EG1821-ND)
 | 2K (202) trim potentiometer | TM6 | 1 | Vishay CT6EP202 Any ceramic trim-pot with the same pinout is OK | Digikey (http://www.digikey.com/scripts/DkSearch/dksus.dll?Detail?name=CT6EP202-ND)
 | 5K (502) trim potentiometer | TM5 | 1 | Vishay CT6EP502 Any ceramic trim-pot with the same pinout is OK | Digikey (http://www.digikey.com/scripts/DkSearch/dksus.dll?Detail?name=CT6EP502-ND)
 | 50K (503) trim potentiometer | TM4 | 1 | Vishay CT6EP503 Any ceramic trim-pot with the same pinout is OK | Digikey (http://www.digikey.com/scripts/DkSearch/dksus.dll?Detail?name=CT6EP503-ND)
 | 500K (504) trim potentiometer | TM3 | 1 | Vishay CT6EP504 Any ceramic trim-pot with the same pinout is OK | Digikey (http://www.digikey.com/scripts/DkSearch/dksus.dll?Detail?name=CT6EP504-ND)
 | 50K D (log) potentiometer | VR3 VR5 VR8 | 3 | Panasonic EVU-F2LFL3D54 (http://na.industrial.panasonic.com/) | Digikey (http://www.digikey.com/scripts/DkSearch/dksus.dll?Detail?name=P3L2503-ND)
 | 50K B (linear) potentiometer | VR2 VR7 | 2 | Panasonic EVU-F2LFL3B54 (http://na.industrial.panasonic.com/) | Digikey (http://www.digikey.com/scripts/DkSearch/dksus.dll?Detail?name=P3K1503-ND)
 | 50K B (linear) dual potentiometer | VR4 | 1 | Alpha RV112BCF-40-25F-B54 | Mouser (http://www.mouser.com/Search/ProductDetail.aspx?qs=B0UqcnvkTvZ34gJdwoXOUQ==)
 | 1Meg A (log) dual potentiometer | VR6 | 1 | Alpha RV112BCF-40-25F-A16 | Mouser (http://www.mouser.com/search/ProductDetail.aspx?R=317-2102F-1M)
 | Switch cap (white) |  | 8 | ITT PE/WHT | Digikey (http://www.digikey.com/scripts/DkSearch/dksus.dll?Detail?name=401-1155-ND) Newark (http://www.newark.com/jsp/displayProduct.jsp?sku=49H6724)
 | Switch cap (black) |  | 15 | ITT PE/BLK | Digikey (http://www.digikey.com/scripts/DkSearch/dksus.dll?Detail?name=401-1152-ND) Newark (http://www.newark.com/jsp/displayProduct.jsp?sku=49H6721)
 | Potentiometer knob | VR2' VR3' VR4' VR5' VR6' VR7' VR8' S2' | 8 | Eagle Plastic Devices Soft Touch Knob | Mouser (http://www.mouser.com/search/ProductDetail.aspx?R=450-4760virtualkey56100000virtualkey450-4760)
 | Switch knob | S3' S4' | 2 | Davies 1510AH | Allied (http://alliedelec.com/Search/ProductDetail.asp?SKU=543-1510&MPN=1510AH)
 | 15/32" x 1/4" x 4-40 standoff |  | 3 | Generic | McMaster (http://www.mcmaster.com/itm/find.ASP?tab=find&context=psrchDtlLink&fasttrack=False&searchstring=91780A435)
 | 3/8" x 1/4" x 4-40 standoff |  | 4 | Generic | McMaster (http://www.mcmaster.com/itm/find.ASP?tab=find&context=psrchDtlLink&fasttrack=False&searchstring=91780A163)
 | 4-40 lock washer |  | 7 | Generic | McMaster (http://www.mcmaster.com/itm/find.ASP?tab=find&context=psrchDtlLink&fasttrack=False&searchstring=98438A210)
 | 4-40 washer |  | 4 | Generic | McMaster (http://www.mcmaster.com/itm/find.ASP?tab=find&context=psrchDtlLink&fasttrack=False&searchstring=92141A005)
 | 4-40 x 1/4" hex button |  | 7 | Generic | McMaster (http://www.mcmaster.com/itm/find.ASP?tab=find&context=psrchDtlLink&fasttrack=False&searchstring=92949A107)
 | 4-40 x 1/4" phillips button |  | 7 | Generic | McMaster (http://www.mcmaster.com/itm/find.ASP?tab=find&context=psrchDtlLink&fasttrack=False&searchstring=90272a106)
 | 4-40 x 1/2" phillips cheesehead/fillister |  | 4 | Comes with case | McMaster (http://www.mcmaster.com/itm/find.ASP?tab=find&context=psrchDtlLink&fasttrack=False&searchstring=91737A084)
 | Rubber feet |  | 4 | Comes with case
 | 6 wire jumper ribbon cable OR 9 wire and 6 wire |  | 4 OR 2 x 9c and 1x 6c | Molex WM09-06, WM06-06, WM03-06 | Digikey (http://www.digikey.com/scripts/DkSearch/dksus.dll?Detail?name=WM06-06A-ND)
Image | Description | Part number | Qty | Manufacturer & Datasheet | Distributor
 | 2.4K 1% resistor Red Yellow Black Brown Brown | R5 | 1 | Generic | Any
 | 5.6K 1% resistor Green Blue Black Brown Brown | R4 | 1 | Generic | Any
 | 24.0K 1% resistor Red Yellow Black Red Brown | R106 | 1 | Generic | Any
 | 200K 1% resistor | R74, R75, R76, R77, R78, R79, R80, R81, R82, R83, R84, R85, R86, R87, R88, R89, R90 | 17 | Generic | Any
 | 1K PTC Thermistor Brown Black Red Brown Green | R100A, R100B | 2 | Microohm LPTC12T21001 (http://www.micro-ohm.com/temperature/temprecflm.html) | Adafruit (http://www.adafruit.com/)
 | 0.1uF (104) ceramic capacitor | C1 C2 C4 C6 C103 C104 C106 C107 C108 C109 C110 C111 C112 C113 C202 C204 | 16 | AVX SR205E104MAR | Mouser (http://www.mouser.com/search/ProductDetail.aspx)Digikey (http://www.digikey.com/scripts/DkSearch/dksus.dll?PName?Name=P4923-ND)
 | 1.0uF (105) tantalum capacitor | C42 C62 | 2 | Kemet T350A105K035AT (http://www.kemet.com/datasheets&T350A105K035AT) | Digikey (http://www.digikey.com/scripts/DkSearch/dksus.dll?Detail?name=399-3529-ND) Mouser (http://www.mouser.com/search/ProductDetail.aspx)
 | .001uF (2A102K) polyester capacitor | C34 C100 C101 | 3 | Xicon PM2A102K | Mouser (http://www.mouser.com/search/ProductDetail.aspx)
 | .0068uF (2A682K) polyester capacitor | C47 | 1 | Xicon PF2A682K | Mouser (http://www.mouser.com/search/ProductDetail.aspx)
 | .01uF (2A103K) polyester capacitor | C10 C20 C21 C33 C46 | 5 | Xicon PM2A103K | Mouser (http://www.mouser.com/search/ProductDetail.aspx)
 | .018uF (2A183K) polyester capacitor | C18 | 1 | PF2A183K | Mouser (http://www.mouser.com/search/ProductDetail.aspx)
 | .033uF (2A333K or J) polyester capacitor | C19 C24 C26 C36 C201 | 5 | PM2A333K | Mouser (http://www.mouser.com/search/ProductDetail.aspx)
 | .047uF (2A473K) polyester capacitor | C54 | 1 | PM2A473K | Mouser (http://www.mouser.com/search/ProductDetail.aspx)
 | .068uF (2A683K) polyester capacitor | C45 | 1 | PF2A683K | Mouser (http://www.mouser.com/search/ProductDetail.aspx)
 | .1uF (2A104K) polyester capacitor | C25 C27 C41 | 3 | PM2A104K | Mouser (http://www.mouser.com/search/ProductDetail.aspx)
 | .22uF (2A224K) polyester capacitor | C35 | 1 | PM2A224K | Mouser (http://www.mouser.com/search/ProductDetail.aspx)
 | 1.0uF 50V electrolytic capacitor | C11 C13 C14 C15 C17 C22 C23 C29 C38 C105 C58 C59 C56 | 13 | Generic | Mouser (http://www.mouser.com/search/ProductDetail.aspx)
 | 2.2uF 50V electolytic capacitor | C51 | 1 | Generic | Mouser (http://www.mouser.com/search/ProductDetail.aspx)
 | 10uF 16V (or 35V) electrolytic capacitor | C16 C30 C31 C32 C37 C40 C50 C52 C60 C61 C72 C203 C205 | 13 | Generic | Mouser (http://www.mouser.com/search/ProductDetail.aspx)
 | 47uF 10V electrolytic capacitor | C28 C44 C53 C55 | 4 | Generic | Mouser (http://www.mouser.com/search/ProductDetail.aspx)
 | 100uF 10V electrolytic capacitor | C48 C49 C102 | 3 | Generic | Mouser (http://www.mouser.com/search/ProductDetail.aspx)
 | 100uF 25V electrolytic capacitor | C7, C8 | 2 | Generic | Mouser (http://www.mouser.com/search/ProductDetail.aspx)
 | 1000uF 10V electrolytic capacitor | C43 | 1 | Generic | Mouser (http://www.mouser.com/search/ProductDetail.aspx)
 | 2200uF 16V electolytic capacitor | C3, C5 | 2 | Generic | Mouser (http://www.mouser.com/search/ProductDetail.aspx)
