x0xb0x/x0xb0x.github.io/assets/media/x0xb0x/x0xbox_mainpanel_march2.dxf

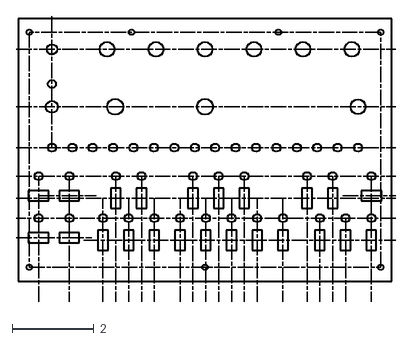
[picture p81: CAD file, 2016-02-27]
assets/media/x0xb0x/x0xbox_mainpanel_march2.dxf
9.30 x 6.98
