x0xb0x/x0xb0x.github.io/assets/media/x0xb0x/x0xb0x_iopanel_march2.dxf

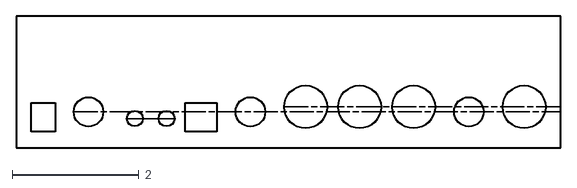
[picture p82: CAD file, 2016-02-27]
assets/media/x0xb0x/x0xb0x_iopanel_march2.dxf
8.58 x 2.07
