x0xb0x/x0xb0x.github.io/_layouts/make.html

{% include head.html %} {% include header.html %}

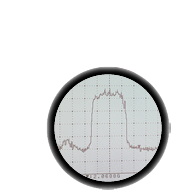
[picture p83: assets/images/wavebubble/topheaderbadge.png]


x0xb0x User Manual: Developing firmware

- About
- F.A.Q.
- Samples
- Gallery
- Mods
- Make it!
  - Parts
  - Tools
  - Preparation
  - Power
  - VCO
  - VCF
  - Envelope
  - VCA
  - Headphone
  - I/O Board
  - Sequencer
  - Finishing
- Use it!
- Firmware (http://sourceforge.net/projects/x0xb0x/)
- Software
- Download
- Resources
- Forums (http://forums.ladyada.net/)
- Wiki (http://www.ladyada.net/wiki/x0x:x0xd0x)

Fork me on GitHub (https://github.com/x0xb0x/x0xb0x.github.io)

{{ content }}

{% include footer.html %}
