x0xb0x/x0xb0x.github.io/pages/ladyada.net/make/x0xb0x/fab/powersupply.html

--- layout: make title: Powersupply ---

Introduction

The power supply is the first thing to build. Getting this part right is key! A bad power supply will keep the rest of the synth from working & can damage parts so be sure to test it after its built.

The power supply takes the 9VAC from the power plug and doubles it to 18VAC which then gets regulated down to 12VDC, 5VDC, 6VDC and 5.333VDC.

Despite having multiple warnings, in large red text, a surprising number of people screw up this section by not checking the resistor values with a multimeter, or verifying that they have purchased a 9VAC adaptor. They then spend a week on the forums trying to debug the problem, which is not fun for anyone involved! Please make sure you have the right parts before you solder them in, eh?

Read the x0xwiki on the power supply (http://www.ladyada.net/wiki/x0x/powersupply) to understand what its doing, before you jump in.

Tips

Check all the resistor values with a multimeter before you solder them in, especially if this is the first time you are trying to read color codes! 90% of problems at this stage are due to incorrect resistors, especially R3, R4 and R5. (The other 10% is due to people using 9VDC adaptors instead of 9VAC.)

Do not continue if you can't get this part working: you can easily damage the kit.

You can always click on the images to zoom in if you need more detail.

Parts List

Image | Description | Part number | Notes
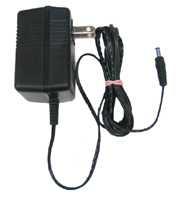
[picture p84: assets/images/parts/acplug_t.jpg]
 | 9VAC transformer wall wart 300-500mA 2.1mm plug | | Make sure this is 9VAC, a common problem is using a 9VDC adaptor.
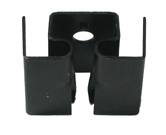
[picture p85: assets/images/parts/to220-heatsink_t.jpg]
 | Heat sink (TO-220 size) | IC20' | Slips on the 5V regulator to keep it from overheating
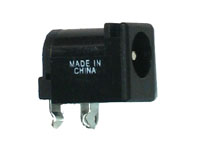
[picture p86: assets/images/parts/21mmjack_t.jpg]
 | 2.1mm power jack | POWER | Plug the 9VAC adaptor into here
 | 1N4001 (generic) | D40-D43 | These form a full wave rectifier that smooths the AC voltage into DC
 | 1N4148 (generic) | D44-D47

 |  |  |  |  |  | 
100 ohm 5% resistor (brown black brown gold) | R1

 |  |  |  |  |  | 
1K 5% resistor (brown black red gold) | R2

 |  |  |  |  |  | 
1.8K 5% resistor (brown grey red gold) | R179

 |  |  |  |  |  | 
2.2K 5% resistor (red red red gold) | R178

 |  |  |  |  |  | 
6.8K 5% resistor (blue grey red gold) | R3 | Do not confuse this with the 68K resistor
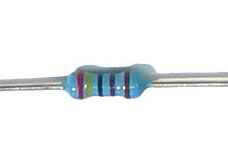
[picture p87: assets/images/parts/2.4k_1p.jpg]
 | 2.4K 1% resistor (red yellow black brown brown) | R5 | Do not confuse this with the 24K resistor
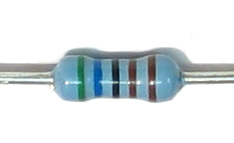
[picture p88: assets/images/parts/5.60K.jpg]
 | 5.6K 1% resistor (green blue black brown brown) | R4 | Do not confuse this with a different 1% resistor
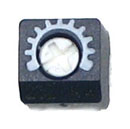
[picture p89: assets/images/parts/trim_t.jpg]
 | 2K (202) trim potentiometer | TM6 | Be sure it says 202 on the edge, or use the multimeter across the two far points to verify its 2K ohm.
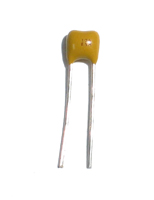
[picture p90: assets/images/parts/104cerm_t.jpg]
 | .1uF (104) ceramic capacitor | C1, C2, C4, C6 | Small bypass capacitors
 | 10uF electrolytic capacitor | C60, C61 | Capacitors are directional, and will be destroyed if soldered in backwards.
 | 100uF 25V electrolytic capacitor | C7, C8 | Capacitors are directional, and will be destroyed if soldered in backwards.
 | 2200uF electolytic capacitor | C3, C5 | Capacitors are directional, and will be destroyed if soldered in backwards.
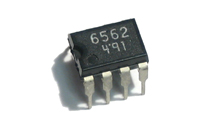
[picture p91: assets/images/parts/an6565_t.jpg]
 | AN6562 8-DIP dual Op-Amp | IC23 | Do not confuse with the EEPROM chip which may look similar. Look for 6562 on top.
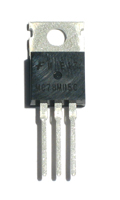
[picture p92: assets/images/parts/7805_t.jpg]
 | (78x05) 5V voltage regulator, 1.0A | IC20 | This part is directional, make sure to put it in the right way.
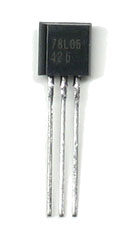
[picture p93: assets/images/parts/78l06_T.jpg]
 | (78L06) 6V voltage regulator, 0.1A | IC21 | Make sure it says 78L06 on it
 | (LM336Z-5.0) 5V voltage reference | IC22 | Make sure it says LM336 on it.

Preparation

Before you start, do some preparatory work!

Learn how to use a multimeter! (https://learn.adafruit.com/multimeters/)

Learn how to solder! (http://www.ladyada.net/learn/soldering/)

Test the 9VAC adaptor:

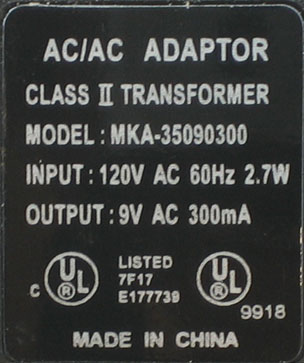
[picture p94: assets/images/metertutorial/9vactransdetail.jpg]
 (http://www.flickr.com/photo_zoom.gne?id=1282113408&size=l)

Make sure you have a 9V AC transformer adaptor, look for these hints that indicate its AC output. If your kit came with a power supply this isn't necessary

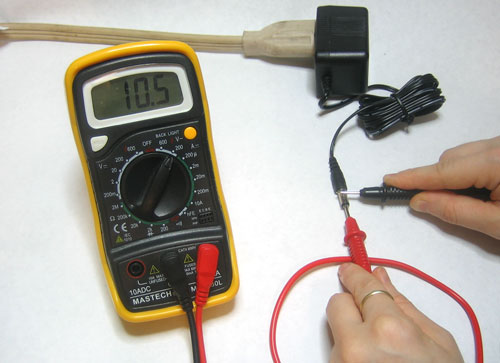
[picture p95: assets/images/metertutorial/9vactestac_t.jpg]


Measure the output, make sure its at least 10V AC. There is a tutorial on how to measure AC voltages here. (https://learn.adafruit.com/multimeters/)

Test and measure all resistors:

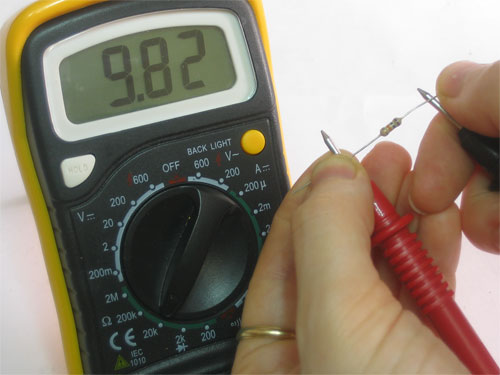
[picture p96: assets/images/metertutorial/range10k2_t.jpg]


Use your multimeter to measure all the resistors, this will take 3 minutes now and save you a half an hour later. There is a tutorial on how to measure resistors here. (https://learn.adafruit.com/multimeters/)

Also, test the 2K trimpot, make sure you've got the 2Kohm version and not one of the other 3 trimpots.

Time to solder!

Ok get your tools ready

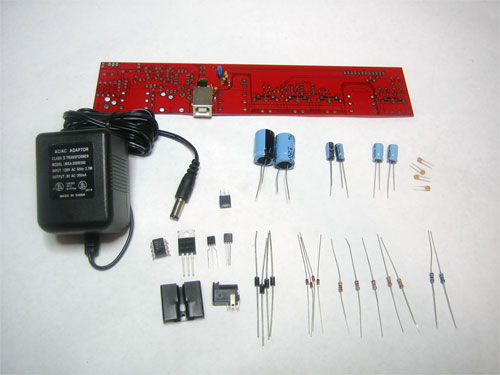
[picture p97: assets/images/x0xb0x/fab/ps/psupparts_t.jpg]
 (http://www.flickr.com/photo_zoom.gne?id=1297460358&size=l) | Check the kit to verify you have all the parts necessary
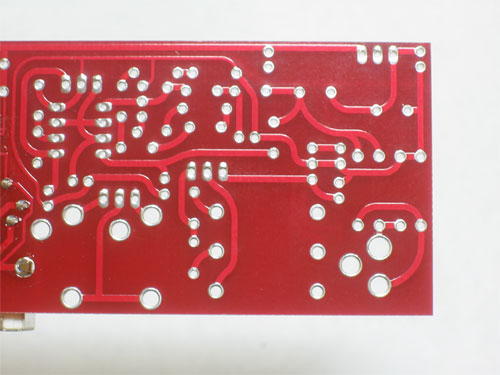
[picture p98: assets/images/x0xb0x/fab/ps/readybot_t.jpg]
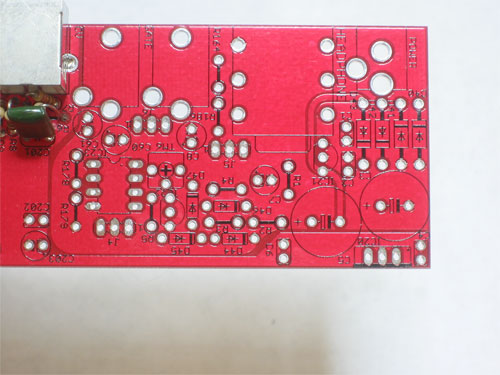
[picture p99: assets/images/x0xb0x/fab/ps/readytop_t.jpg]
  | Place the PCB in a vise or PCB holder
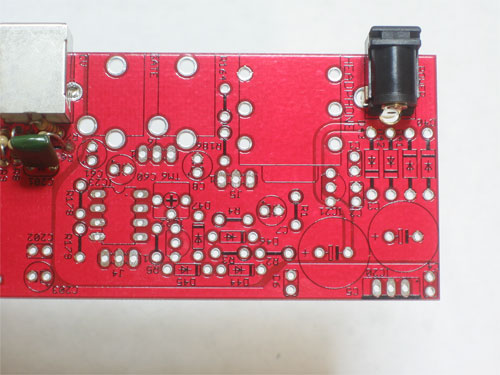
[picture p100: assets/images/x0xb0x/fab/ps/jackplace_t.jpg]
 | The first step is to place the 2.1mm Power Jack as shown
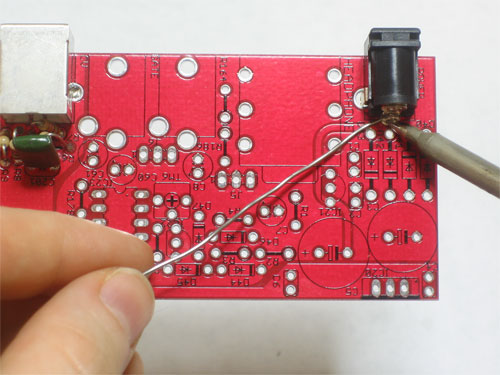
[picture p101: assets/images/x0xb0x/fab/ps/jacktack_t.jpg]
 | You can solder one pin from above, which will keep the jack in place when you turn the PCB over
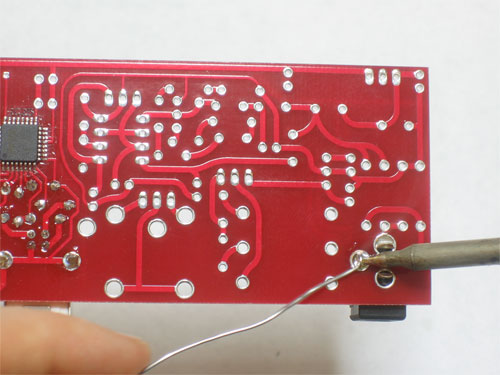
[picture p102: assets/images/x0xb0x/fab/ps/jacksolder_t.jpg]
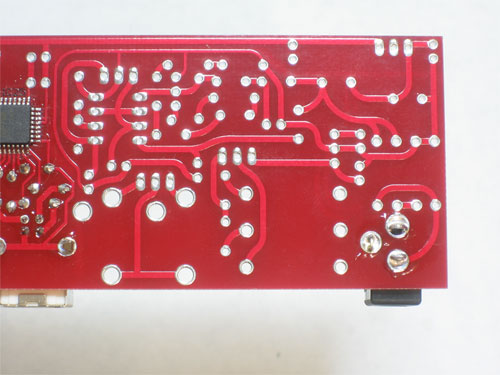
[picture p103: assets/images/x0xb0x/fab/ps/jacksoldered_t.jpg]
  | Turn over the PCB, solder the three pins using plenty of solder to fill in the holes as much as possible.
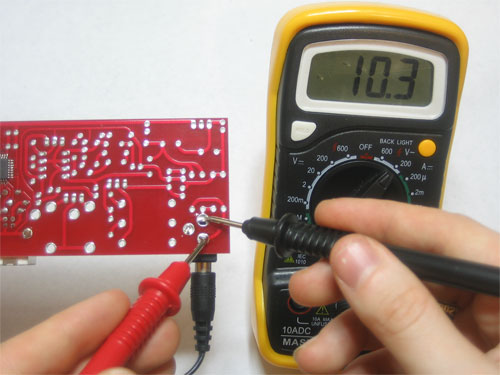
[picture p104: assets/images/x0xb0x/fab/ps/jackmeasure_t.jpg]
 | Insert the 9VAC power plug and use your mulitmeter to measure the voltage across the jack. Make sure its at least 10VAC. All tests on the x0xb0x must be done with the power plugged in (unless otherwise noted) When you are done, remove the power plug. Never solder with the power plug in!
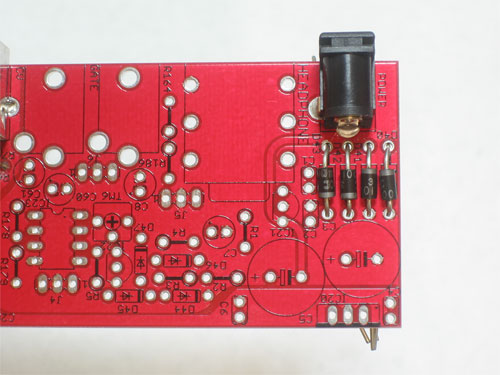
[picture p105: assets/images/x0xb0x/fab/ps/rectplace_t.jpg]
 | Turn the PCB over and place the 4 1N4001 diodes D40, D41, D42, and D43 Diodes are directional, make sure the white stripe at the end of each diode matches the stripe in the picture underneath.
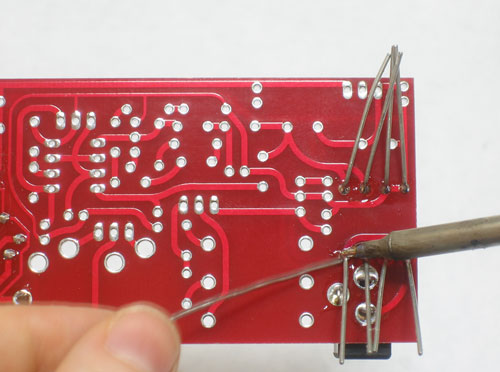
[picture p106: assets/images/x0xb0x/fab/ps/rectsolder_t.jpg]
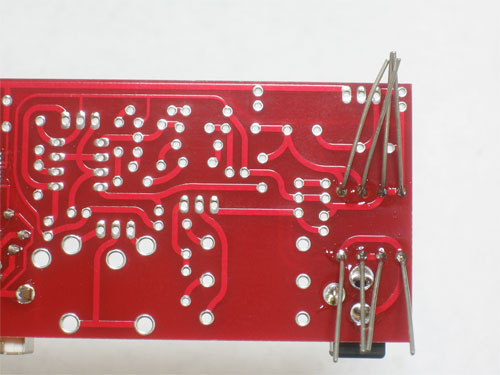
[picture p107: assets/images/x0xb0x/fab/ps/rectsoldered_t.jpg]
  | Solder the diodes in place.
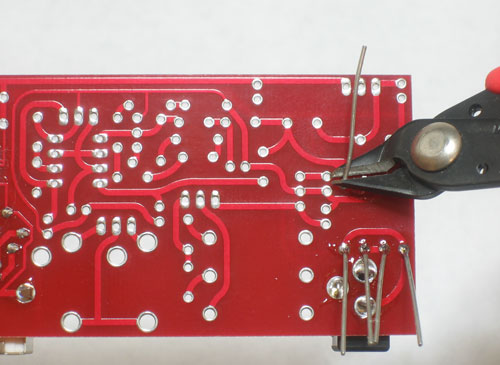
[picture p108: assets/images/x0xb0x/fab/ps/rectclip_t.jpg]
 | Then use the diagonal cutters to clip off the long leads.
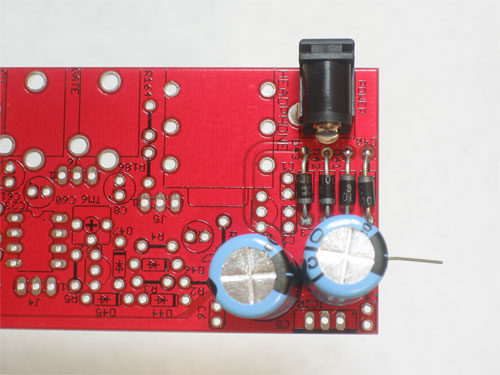
[picture p109: assets/images/x0xb0x/fab/ps/bigcapplace_t.jpg]
 | Next, place the two 2200uF capacitors C3 and C5. Make sure they are placed correctly, with the negative stripes as shown
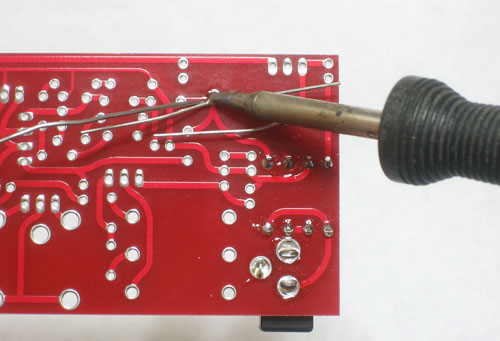
[picture p110: assets/images/x0xb0x/fab/ps/bigcapsolder_t.jpg]
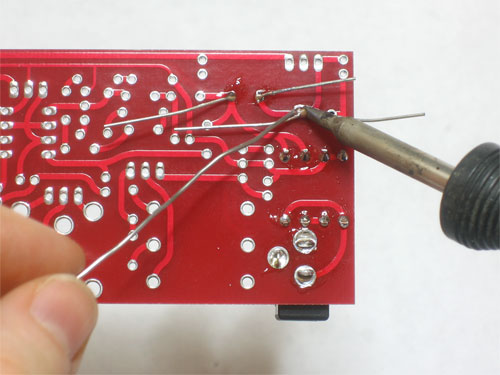
[picture p111: assets/images/x0xb0x/fab/ps/bigcapsolder2_t.jpg]
  | Solder in the capacitors
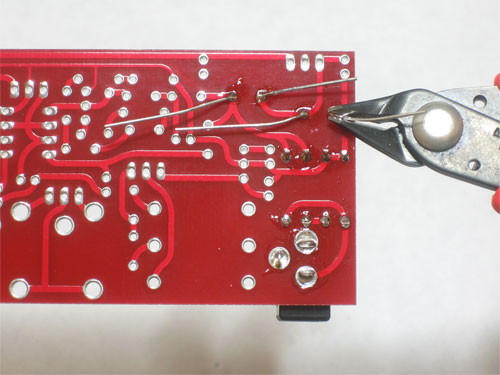
[picture p112: assets/images/x0xb0x/fab/ps/bigcapclip_t.jpg]
 | Clip the long leads
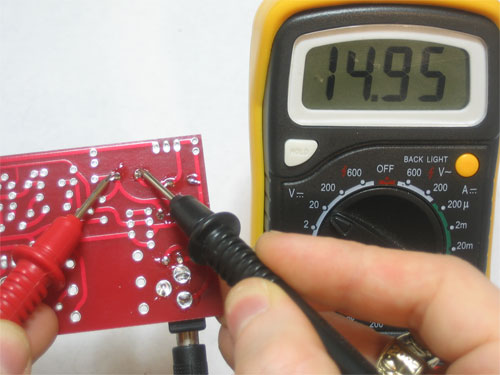
[picture p113: assets/images/x0xb0x/fab/ps/bigcapmeasure_t.jpg]
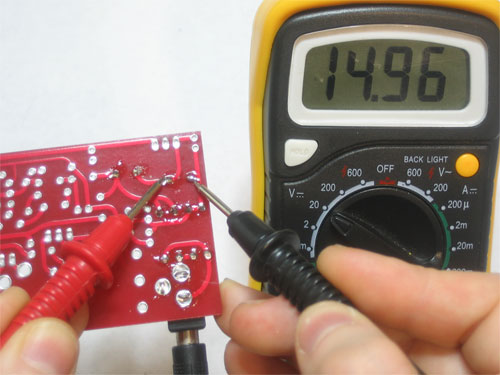
[picture p114: assets/images/x0xb0x/fab/ps/bigcapmeasure2_t.jpg]
  | Try measuring AC voltage across C3 and C5, it should be about 26VAC. Sometimes you can't read the AC voltage across the capacitors, in which case you should try to measure the DC voltage across both capacitors, they should be about 15V DC or higher.
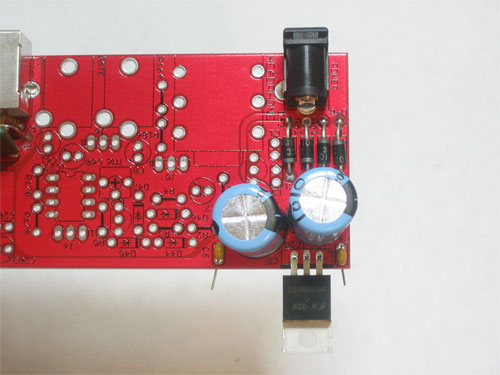
[picture p115: assets/images/x0xb0x/fab/ps/7805place_t.jpg]
 | Place the 7805 5V regulator IC20. Bend it back as shown, this will allow you to put the heatsink on later. Make sure you put the regulator in the right way! Also place C4 and C6 the 0.1uF capacitors. The capacitors are non-directional and can be put it either way.
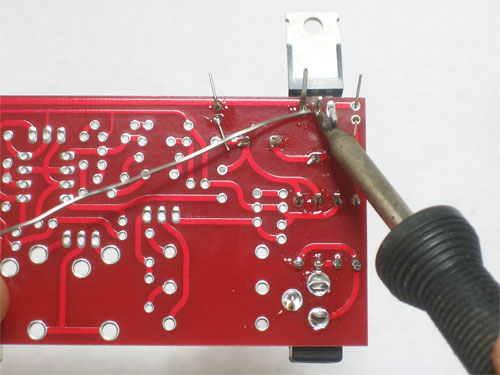
[picture p116: assets/images/x0xb0x/fab/ps/7805solder_t.jpg]
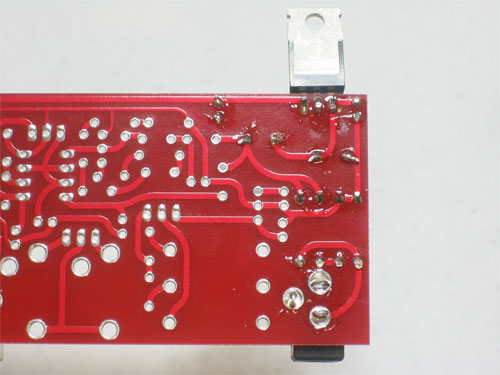
[picture p117: assets/images/x0xb0x/fab/ps/7805soldered_t.jpg]
  | Solder and clip the regulator and two small capacitors
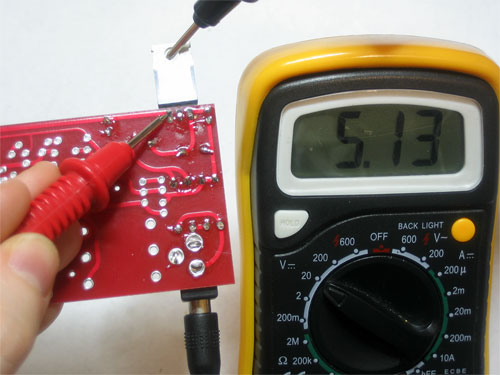
[picture p118: assets/images/x0xb0x/fab/ps/7805measure_t.jpg]
 | Insert the power plug and measure the DC voltage from the metal back of the 7805 (which is tied to ground) and the left-most pin, as shown. The output voltage should be about 5VDC. If it's less than 4.75VDC or higher than 5.25VDC then check to make sure you have assembled everything correctly.
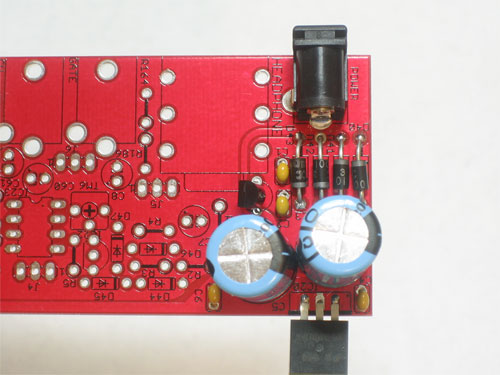
[picture p119: assets/images/x0xb0x/fab/ps/7806place_t.jpg]
 | Place the 7806 6V regulator IC21 and the 2 remaining 0.1uF ceramic capacitors C1 and C2 Make sure you put IC21 in the right way, the curve of the package should match the curve in the image below it. The capacitors are non-directional and can be put it either way.
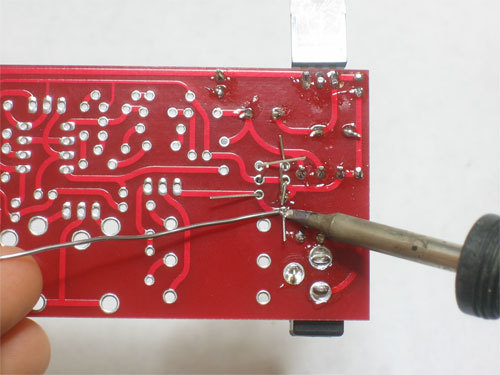
[picture p120: assets/images/x0xb0x/fab/ps/7806solder_t.jpg]
 | Solder and clip the parts
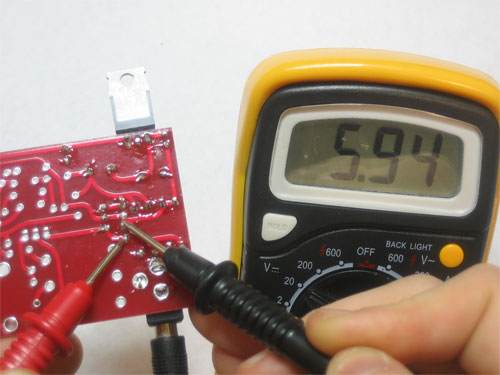
[picture p121: assets/images/x0xb0x/fab/ps/7806measure_t.jpg]
 | Measure the voltage across C1 it should be about 6VDC - between 5.75 and 6.25 is OK.
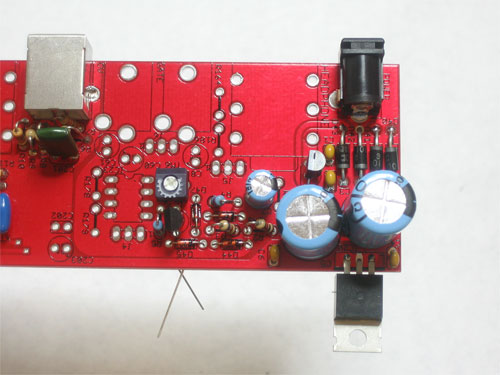
[picture p122: assets/images/x0xb0x/fab/ps/53place_t.jpg]
 | Next up, place the 4 1N4148 diodes D44, D45, D46, and D47 as well as the 2K trimpot TM6, R2 R3, R4, R5, C7 and IC22 Make sure the diode stripes are facing the right way, that the resistors are correct, the trimpot is 2K (202) and that IC22 is placed correctly
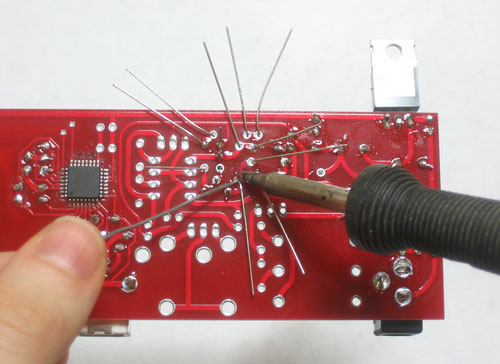
[picture p123: assets/images/x0xb0x/fab/ps/53solder_t.jpg]
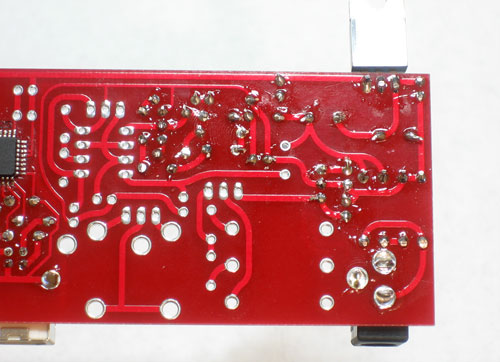
[picture p124: assets/images/x0xb0x/fab/ps/53soldered_t.jpg]
  | Flip over the PCB and solder in all the parts, then clip the leads
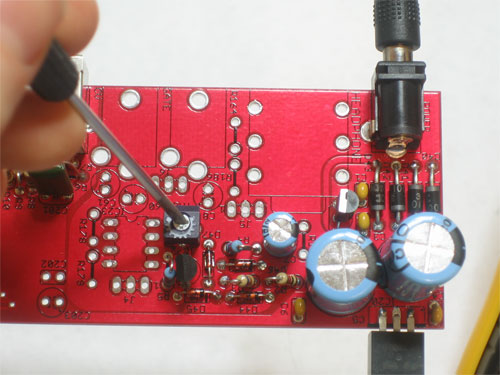
[picture p125: assets/images/x0xb0x/fab/ps/trimadjust_t.jpg]
 | The trimpot is used to adjust the 5.333V reference voltage which is used by the VCO to create notes. Use a thin screwdriver to gently turn the potentiometer. Do not be rough with it, or try to force it past its hard limit.
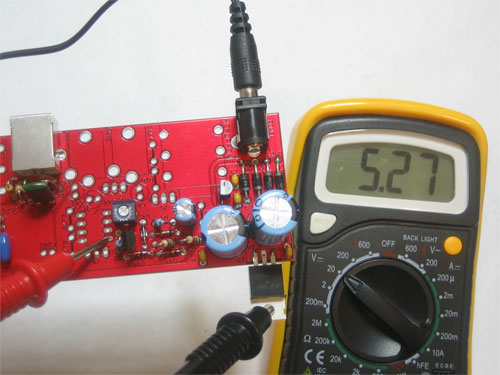
[picture p126: assets/images/x0xb0x/fab/ps/53adjustmin_t.jpg]
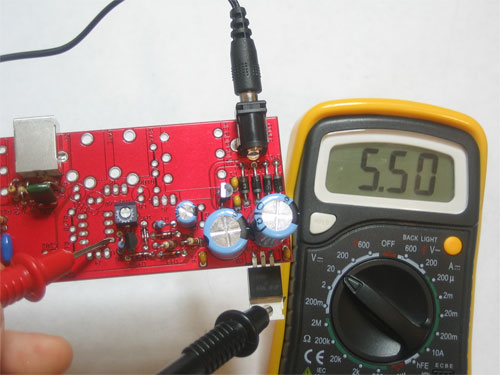
[picture p127: assets/images/x0xb0x/fab/ps/53adjustmid_t.jpg]
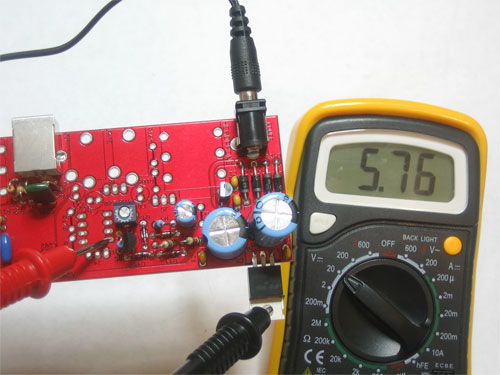
[picture p128: assets/images/x0xb0x/fab/ps/53adjustmax_t.jpg]
   | You should be able to adjust the trimpot so that it ranges from about 5.25 to 5.75VDC. What is most important is that it can be set to less than 5.3V and higher than 5.4V. You can measure the voltage at pin #5 of IC23 as shown. You can use the heatsink of the 7805 as ground reference. Do not trim the potentiometer to 5.333V yet, just check to make sure the range is there
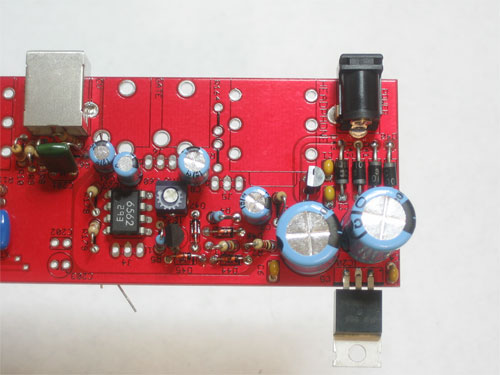
[picture p129: assets/images/x0xb0x/fab/ps/finalplace_t.jpg]
 | Place the remaining parts: IC23 (AN6562 op-amp), R1, C8, C60, C61, R178 and R179 Make sure the opamp is placed properly. The notch in the chip should match the notch in the silkscreened image. If you are nervous about soldering in ICs, you may want to buy sockets for the chips.
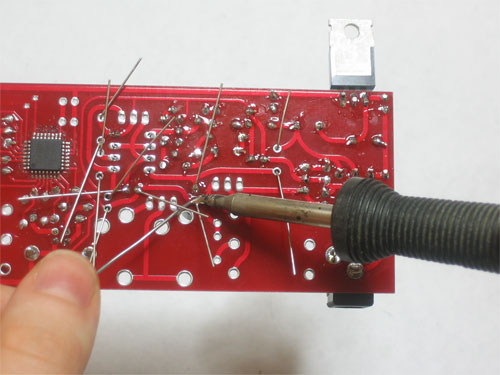
[picture p130: assets/images/x0xb0x/fab/ps/finalsolder_t.jpg]
 | Solder in all of the parts and clip the leads
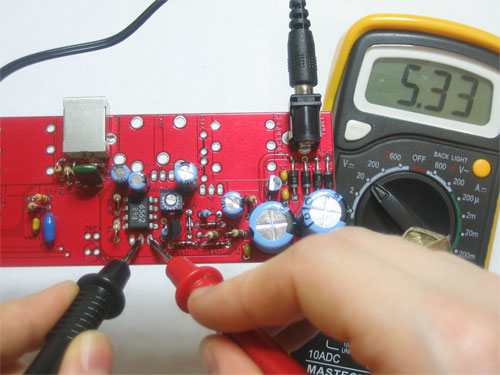
[picture p131: assets/images/x0xb0x/fab/ps/53test_t.jpg]
 | Now you can tune the 5.333V reference, measuring the voltage on J4 as shown
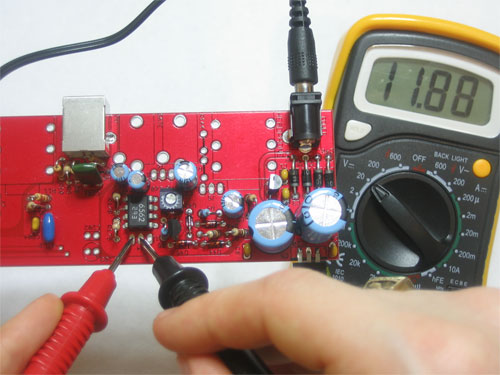
[picture p132: assets/images/x0xb0x/fab/ps/12vtest_t.jpg]
 | Finally, test the +12V supply as shown using your multimeter. The voltage should be between 11.75V and 12.25V
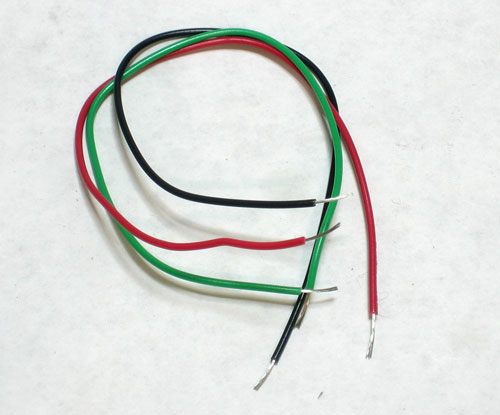
[picture p133: assets/images/x0xb0x/fab/ps/wires_t.jpg]
 | Cut 3 wires, at least 6" long, strip the ends and tin them. The two side colors don't matter but make sure one is black, it will make it easy to remember that the middle pin or J4 is ground.
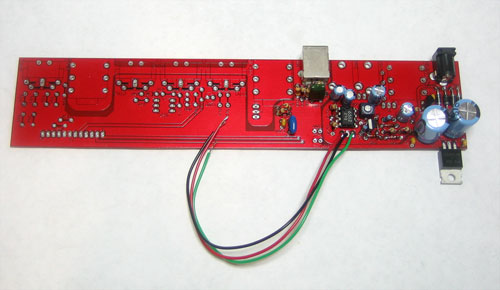
[picture p134: assets/images/x0xb0x/fab/ps/done_t.jpg]
 | Solder the wires into J4 with the black wire in the middle

Trouble shooting

Doesn't work? Try out the suggestions before posting on the forum

1. Is it plugged in? Remember, you can't test voltage without power
2. Are you using the right kind of adaptor? x0xb0x needs a 9VAC adaptor, not a 9VDC adaptor. It will not work with a DC adaptor! See the preparatory steps for instructions on how to verify that it is a 9V AC adaptor
3. Are you measuring the voltages (AC or DC) correctly with the multimeter Multimeters are all very similar in practice, but have different interfaces. Make sure you are measuring voltage correctly. Unless otherwise mentioned, the voltages are taken with respect to ground (the middle pin of J4, or the heatsink of the 7805 for example) Here is a tutorial on how to use a multimeter (https://learn.adafruit.com/multimeters/)
4. Are the electrolytic (blue cylindrical) capacitors in backward? Check that they look like the images above, putting them in backwards will create a short.
5. Are the resistors the correct values? Check them again, and in good light. If you want to measure the resistance with a multimeter they cannot be in the circuit: you will not get the correct reading while they are soldered it.
6. Go through all of the tests starting from the beginning. Always go back and verify your previous readings: test the jack voltage, then the voltage across C3 and C5, etc.

May 17, 2011 20:07
