x0xb0x/x0xb0x.github.io/pages/ladyada.net/make/x0xb0x/fab/tools.html

--- layout: make title: Tools ---

Tools

There are a few tools that are required for assembly. None of these tools are included. If you don't have them, now would be a good time to borrow or purchase them. They are very very handy whenever assembling/fixing/modifying electronic devices! I provide links to buy them, but of course, you should get them whereever is most convenient/inexpensive. Many of these parts are available in a place like Radio Shack or other (higher quality) DIY electronics stores.

I recommend a "better" electronics tool set for this kit, which I describe here.

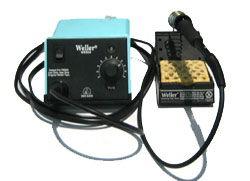
[picture p135: assets/images/tools/wes50_t.jpg]
 | Soldering iron. One with temperature control and a stand is best. A conical or small 'screwdriver' tip is good, almost all irons come with one of these. A low quality (ahem, $15 radioshack) iron will cause more problems than its worth. I cannot emphasise enough how important a good iron is. Why save a few $ and destroy a $350 kit? Check out my recommended iron and where to buy.
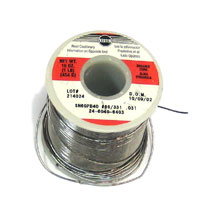
[picture p136: assets/images/tools/solderroll_t.jpg]
 | Solder. Rosin core 60/40. Good quality solder is a good thing. Cheap solder leads to bridging and cold solder joints which can be tough to find. Dont buy a tiny amount: a 1/2 lb. spool should suffice. Check out my recommended solder and where to buy.
| Thin (Silver) Solder or Solder Paste. For soldering the surface mount component
| Power Supply It can be a thousand dollar arbitrary waveform generator, or a 9V hooked up to an LM317 & potentiometer. See below for instructions on how to make one
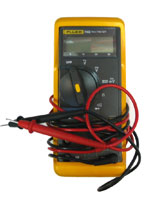
[picture p137: assets/images/tools/meter_t.jpg]
 | Multimeter A handheld meter, at least, is necessary.A multimeter with a transistor (hfe) checker is handy for categorizing the '733 transistors Check out my recommended multimeters and where to buy.
| Oscilloscope A 'scope is even more handy for debugging & analyzing circuits. For audio hacking, you may want to look into software "soundcard oscilloscopes" see below for details.
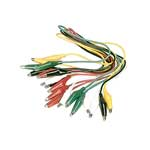
[picture p138: assets/images/tools/alligtest_t.jpg]
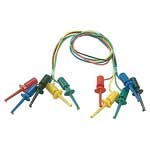
[picture p139: assets/images/tools/testclips_t.jpg]
  | Alligator Clips and/or Test Clips Will be essential when it comes to testing parts of the kit with a multimeter, or for applying voltages to the kit for testing. Part numbers are available here
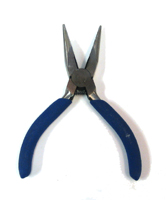
[picture p140: assets/images/tools/needlenose_t.jpg]
 | Needle-nose pliers. For bending leads, etc.
 | Tweezers. For holding components steady. Check out my recommended tweezers and where to buy.
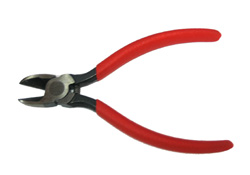
[picture p141: assets/images/tools/dikes_t.jpg]
 | Dikes/large diagonal cutters. For cutting potentiometers down.
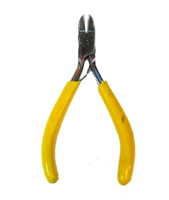
[picture p142: assets/images/tools/flush_t.jpg]
 | Flush/diagonal cutters. Essential for cutting leads close to the PCB. Check out my recommended flush cutters and where to buy.
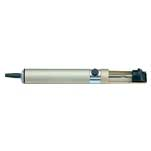
[picture p143: assets/images/tools/soldersucker_t.jpg]
 | Desoldering tool. If you are prone to incorrectly soldering parts. Check out my recommended desoldering tool and where to buy.
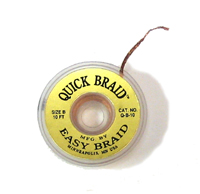
[picture p144: assets/images/tools/braid_t.jpg]
 | (De)solder braid. For fixing solder bridges.
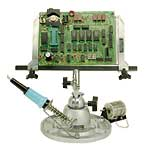
[picture p145: assets/images/tools/panavise.jpg]
 | Board holder. Not necessary but will make things go much much faster. Check out my recommended board holder and where to buy.
| Good light. More important than you think.
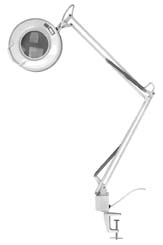
[picture p146: assets/images/tools/litworklamp_t.jpg]
 | Magnifying glass. To examine work carefully.

Audio "Soundcard" Oscilloscopes

Go here for instructions on how to make a soundcard scope probe

I used Zelscope, there's a 14 day trial and it was the first thing that came up on Google so it wins. It probably doesn't matter which audioscope software you use. It'll all be kinda awful.

Here is how I had my audioscope set up for the tests shown in the x0xb0x build manual.

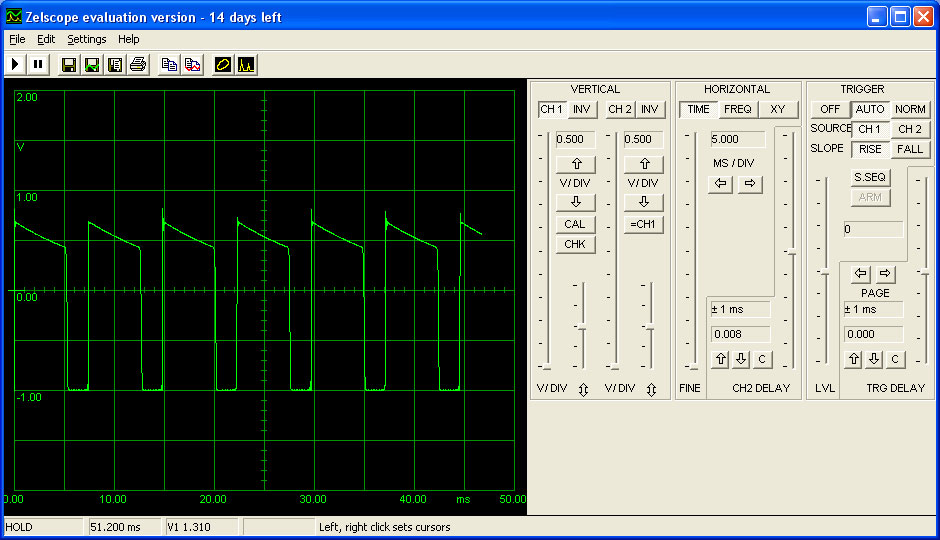
[picture p147: assets/images/x0xb0x/fab/vco/scope-setup.jpg]


Power Supply

Being able to poke voltages into the x0xb0x will help you debug the kit. You can buy an adjustable power supply for $50 or so, or build your own from a another one (http://www.web-tronics.com/15powsupk1.html)) Just look for any power supply kit that has a LM317 in it.

You can also build it for $10 using a 9V battery as input and test clips for outputs. This won't be able to provide a lot of power (cause its just a 9V) but it can go pretty far for testing and debugging

Click here for instructions on how to make your own

May 17, 2011 20:07
