x0xb0x/x0xb0x.github.io/pages/ladyada.net/make/x0xb0x/software/index.html

x0xb0x c0ntr0l software

- About
- F.A.Q.
- Samples
- Gallery
- Mods
- Make it!
- Use it!
- Firmware (http://sourceforge.net/projects/x0xb0x/)
- Software
- Download
- Resources
- Forums (http://forums.ladyada.net/)
- Wiki (http://www.ladyada.net/wiki/x0x:x0xd0x)

Screenshot

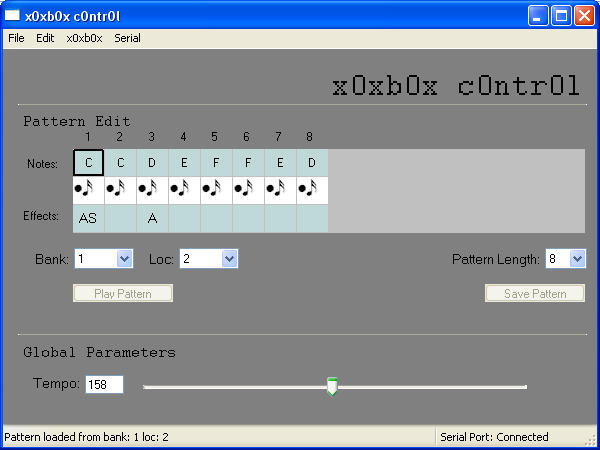
[picture p218: pages/ladyada.net/make/x0xb0x/software/patternloaded.png]


Downloading

You can get the software by downloading the package from sourceforge (http://sourceforge.net/project/showfiles.php?group_id=135597&package_id=168652). Right now only the windows package is up. This will be fixed once I figure out how to make python executables for MacOS X. Linux people can grab the c0ntr0l code from CVS and install Python 2.4/wxPython/pySerial (instructions coming as soon as I get a linux box) Its huge because its really an entire Python/wxPython package wrapped up together with a 10kB python script.

Also make sure you have the most recent firmware (http://sourceforge.net/projects/x0xb0x/) uploaded (v1.03 right now). You can upload the firmware using the c0ntr0l software but you cant use it with the x0x otherwise. Second run x0xb0x (99->199) have 1.03 installed already.

Bootloading

1. Turn on your x0x while it is in Bootload mode. You can't switch to this mode once its turned on so make sure the function knob is right.
2. Plug in the USB cable into your PC
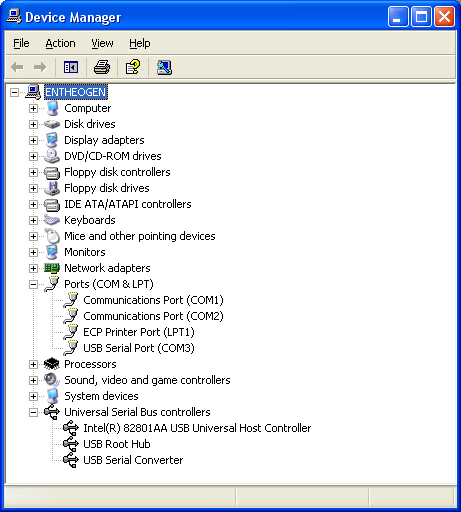
[picture p219: pages/ladyada.net/make/x0xb0x/software/usbfound.png]
3. Use the Hardware/Device manager (control panel) to verify that a USB serial port has been found: 
4. Now double click on c0ntr0l.exe to start the c0ntr0l software
5. Under Serial->Port select the right COM port (in this case, COM3)
6. Select x0xb0x->Upload firmware.. and NOT "connect to x0xb0x"
7. Find the firmware, press OK.
8. Now quit the software.
9. Restart the x0x in non-bootload mode (power-cycle) & follow use below

Using

1. Turn on your x0x in non-bootload mode. Ironically, you don't have to be in Computer Control mode (yet...there may be special functions).
2. Verify that the USB port was found (see image above)
3. Select the correct port in Serial->Port
4. Select Serial->Connect
5. The tempo slider should adjust, and turning the tempo knob should change the slider and vice versa
6. You can now read/write patterns from memory, back up the entire EEPROM (patterns & tracks), cut/paste patterns, rotate, etc.
7. To load a pattern, select the bank/location in the dropdown menus
8. To edit the loaded pattern, set the length with the drop down menu, then click on the top boxes and type in a note (a,b,c,d,e,f,g,h and A,C,D,F,G for sharps) click on the note symbol to change to a rest, and add accent (A), slide (S) and transpose up/down (U/D)
9. Save a pattern by clicking on Save Pattern
10. A lot of work still needs to be done
11. Yes the interface kinda sucks right now.
12. Please post bugs, suggestions, etc to the forum and the sourceforge bugtracking system. This will make my life easier. thanks!

May 17, 2011 20:07
