x0xb0x/x0xb0x.github.io/pages/ladyada.net/make/x0xb0x/manual/index.html

--- layout: default title: Manual ---

Welcome to your x0xb0x

Lets have fun and learn how to make hardcore acid tracks!

<---- This web content is being replaced with a nice printable manual.

This is a link to the manual (http://sourceforge.net/project/showfiles.php?group_id=135597&package_id=221671&release_id=486373) (1meg pdf). It's not done. It's not even edited. Maybe you want to look at it anyways?

May 17, 2011 20:07
