x0xb0x/x0xb0x.github.io/assets/images/tools/solderrollholder_t.jpg

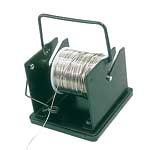
assets/images/tools/solderrollholder_t.jpg
