x0xb0x/x0xb0x.github.io/pages/ladyada.net/make/x0xb0x/fab/images/pcbs.jpg

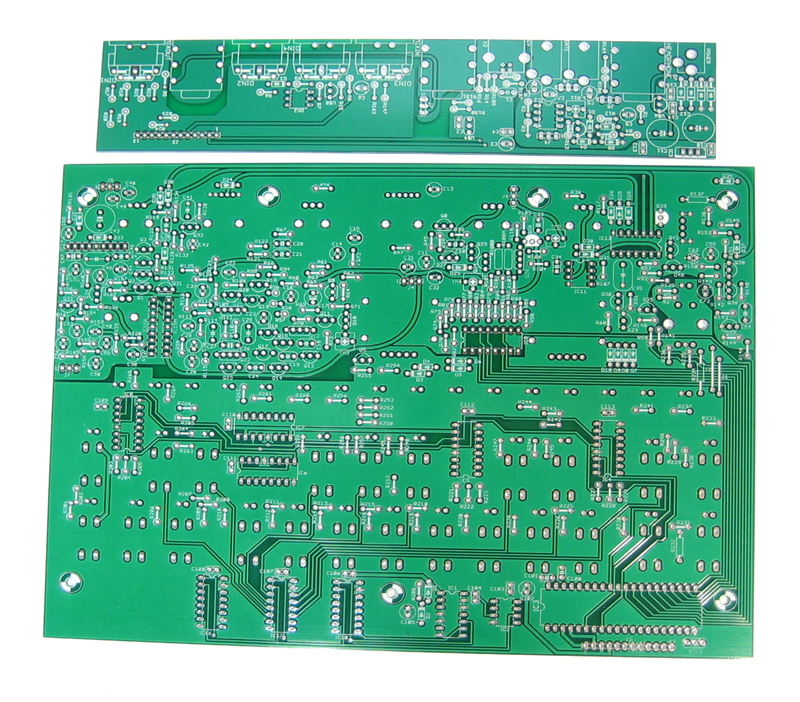
pages/ladyada.net/make/x0xb0x/fab/images/pcbs.jpg
