x0xb0x/x0xb0x.github.io/(threads)

Thread 12 (2019-09-25):

Links to those boards and schematic files are not functioning. Thanks in advance for posting the brd and sch.

01GOD, 2019-09-25:
Links to those boards and schematic files are not functioning. Thanks in advance for posting the brd and sch.

reinvantveer, 2019-10-06:
Thanks for the heads up! Closed with #13

Closed 2019-10-06.

Thread 14 (2019-11-16):

Eagles files for the mainboard wrong

NoSkillsToPayTheBillz, 2019-11-16:
The .Brd files for the main board say they were made in eagle 6.4 the originals are from eagle 4.13 or so it says on the original download page. Either way they are edited and it doesn't have a outline and looks like some one tried to added on very sloppy on layer 20 and there is a few air-wire errors and alot of unconnected wires. I don't know if they are supposed to be like that. But the outline makes it hard to process the files. I didn't no if this goes here or not but since there was a upload not to long ago of the files i figured some one might be able to fix it.

dwestbury, 2020-03-27:
The files I was able to locate online are corrupt and don't load into Eagle?
Are you able to share the files you found?

NoSkillsToPayTheBillz, 2020-03-27:
i used these files someone posted on a forum
[mainboard.zip](https://github.com/x0xb0x/x0xb0x.github.io/files/4394515/mainboard.zip)
[io-board.zip](https://github.com/x0xb0x/x0xb0x.github.io/files/4394517/io-board.zip)

dwestbury, 2020-03-28:
Thanks so much... I see the artifacts, but no BRD file?
Eagle can open the GBL, but only as a text file?
I also have the SCH file file, but this only shows schematic, not the v1 board layout.

dwestbury, 2021-01-11:
Has anyone recently made a PCB from these Gerbers and actually built a working x0xb0x?

reinvantveer, 2021-02-15:
No, they come unaltered from the original site at http://www.ladyada.net/make/x0xb0x/

reinvantveer, 2021-02-15:
But you could ask a manufacturer, I ordered a kit  from a company in Germany long time ago. Adafruit sells a board as well, on https://www.adafruit.com/product/3603 so you could ask around whether they did any updates on the board files

dwestbury, 2021-02-15:
@reinvantveer thanks for confirming...
