x0xb0x/x0xb0x.github.io/assets/media/x0xb0x/mainboard.brd

## EAGLE design assets/media/x0xb0x/mainboard.brd (2019-10-06)

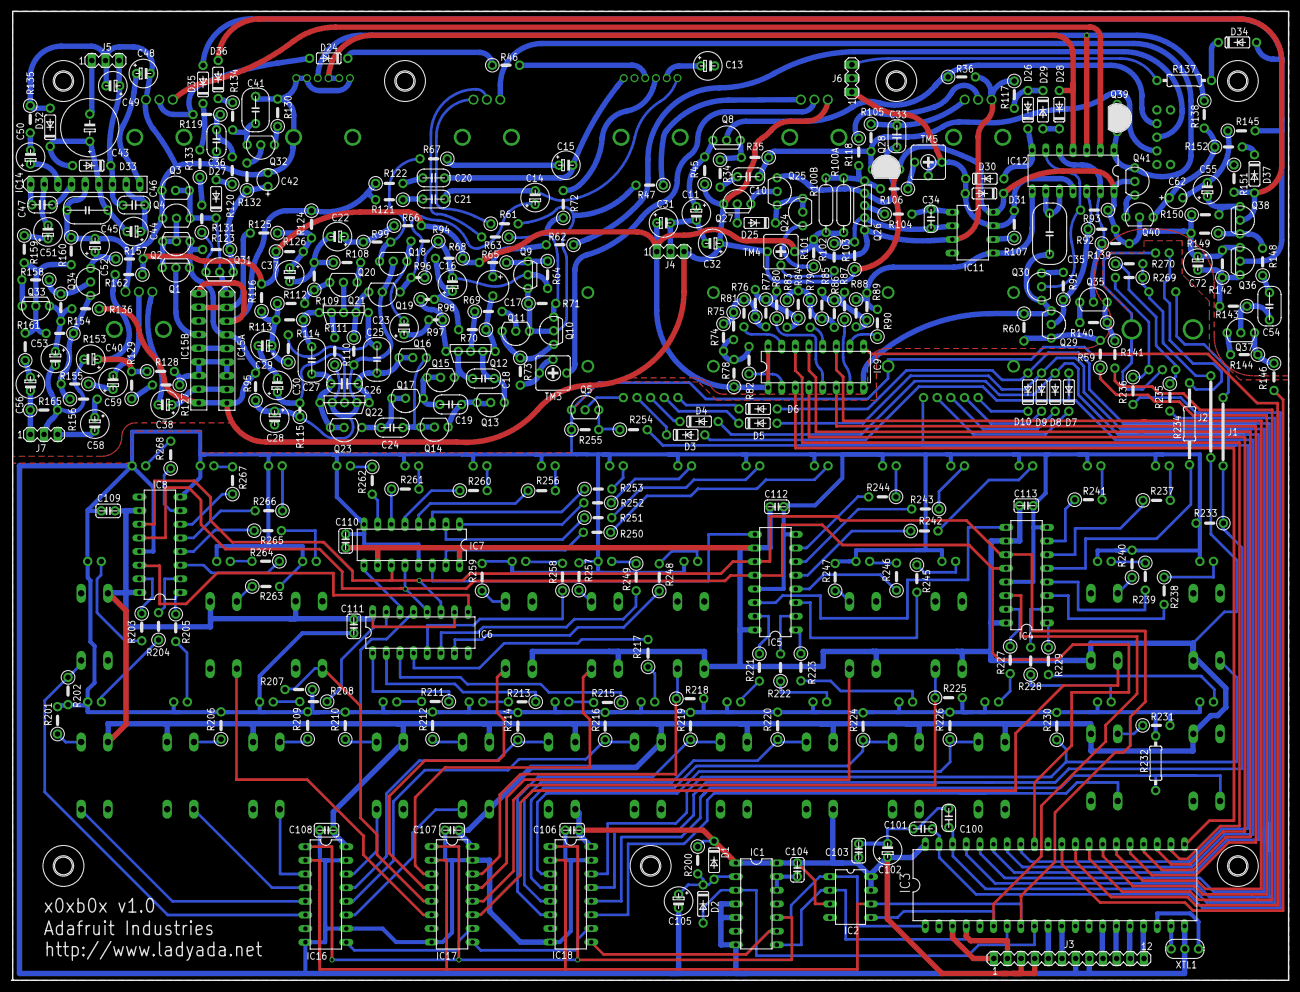
[picture p222: board mainboard.brd from above]

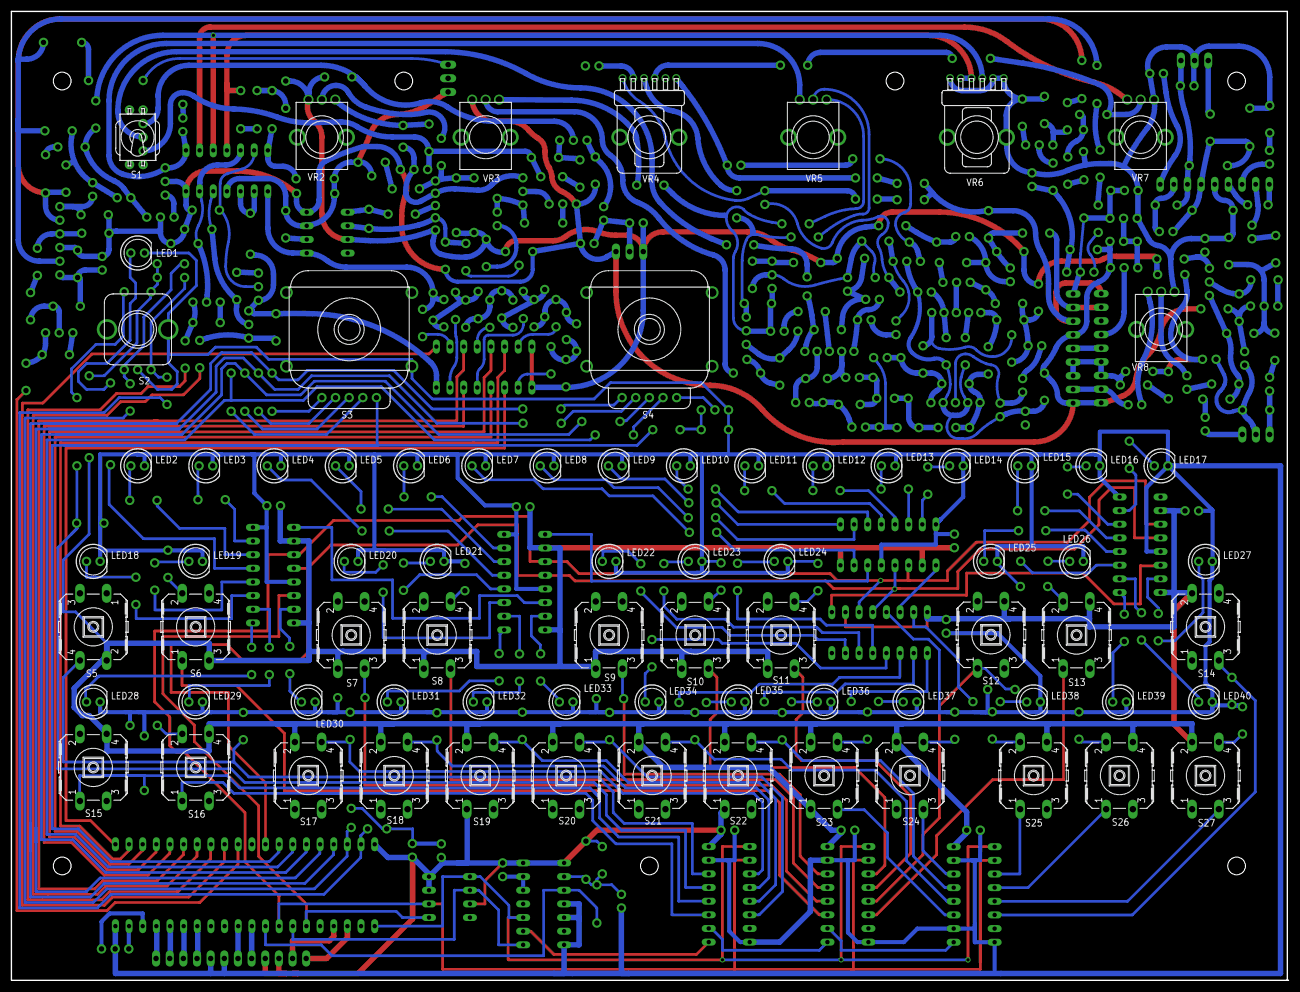
[picture p223: board mainboard.brd from below]

Board: 2 copper layers, 237.5 x 180.3 mm, 417 parts (74 on the bottom side), 324 nets.

Parts:
C10, C20, C21, C33, C46: .01; C050-024X044
C11, C13, C14, C15, C22, C23, C29, C38, C56, C58, C59, C105: 1/50; E5-6
C16, C30, C31, C32, C37, C40, C50, C52, C72: 10/16; E5-6
C17: 1/50; E3,5-8
C18: .018; C050-025X075
C19, C24, C36: .033; C050-025X075
C25, C27, C41: .1; C050-030X075
C26: .033; C075-032X103
C28, C44, C53, C55: 47/16; E5-6
C34, C100, C101: .001; C050-035X075
C35: .22; C050-045X075
C42, C62: 1/35; E2,5-7
C43: 1000/6.3; E5-5
C45: .068; C050-050X075
C47: .0068; C050-075X075
C48, C49: 100/6.3; E5-6
C51: 2.2/50; E5-6
C54: .047; C050-055X075
C102: 100/10; E5-6
C103, C104, C106, C107, C108, C109, C110, C111, C112, C113: .1; C050H075X075
D1, D2, D3, D4, D5, D6, D7, D8, D9, D10, D24, D25, D26, D27, D28, D29, D30, D31, D32, D33, D34, D35, D36, D37: 1N4148; DO35-10
IC1: 74126N; DIL14
IC2: AT25P; DIL08
IC3: MEGA162P; DIL40
IC4, IC5, IC6, IC7, IC8: 74HC595N; DIL16
IC9: 4174P; DIL16
IC11: DIL08
IC12: 4066N; DIL14
IC14: LA44140; SIP9
IC15A: SIP9
IC15B: BA6110; SIP9
IC16, IC17, IC18: 74HC165N; DIL16
J1: J12MM; 12
J2: J15MM; 15
J3: MA12-1
J4, J5, J6, J7: MA03-1
LED1, LED2, LED3, LED4, LED5, LED6, LED7, LED8, LED9, LED10, LED11, LED12, LED13, LED14, LED15, LED16, LED17, LED18, LED19, LED20, LED21, LED22, LED23, LED24, LED25, LED26, LED27, LED28, LED29, LED30, LED31, LED32, LED33, LED34, LED35, LED36, LED37, LED38, LED39, LED40: LED5MM
Q1, Q2, Q8, Q9, Q10, Q27, Q31, Q33, Q36, Q38: 2SA733P; TO92
Q3, Q4, Q5, Q11, Q13, Q14, Q15, Q16, Q18, Q20, Q24, Q25, Q29, Q30, Q32, Q34, Q35, Q37, Q40, Q41: 2SC536F
Q12, Q21, Q26: 2SC1583; SSIP5
Q17, Q23: 2SC536F; 2SC536_UNEVEN
Q19: 2SC536FUNEVEN; 2SC536_UNEVEN
Q22: 2SC2291; SSIP5
Q28, Q39: 2SK30
R34, R36, R47, R61, R64, R65, R94, R101, R105, R109, R112, R116, R142, R143, R144, R145, R148, R149, R201, R202, R203, R204, R205, R206, R207, R208, R209, R210, R211, R212, R213, R214, R215, R216, R217, R218, R219, R220, R221, R222, R223, R224, R225, R226, R227, R228, R229, R230, R231, R233, R237, R238, R239, R240, R241, R242, R243, R244, R245, R246, R247, R248, R249, R250, R251, R252, R253, R254, R255, R256, R257, R258, R259, R260, R261, R262, R263, R264, R265, R266, R267, R268, R269, R270: 10K; 0207/5V
R35, R59, R66, R72, R73, R92, R93, R99, R102, R113, R114, R118, R122, R139, R140, R141, R154, R156, R165: 100K; 0207/5V
R45, R60, R110, R111, R117, R129, R134, R146, R151: 22K; 0207/5V
R46, R119, R127, R155: 47K; 0207/5V
R62, R63, R121, R128, R131: 220K; 0207/5V
R67, R68, R69, R70, R71, R104, R107, R108, R124, R125, R126, R133, R162: 2.2K; 0207/5V
R74, R75, R76, R77, R78, R79, R80, R81, R82, R83, R84, R85, R86, R87, R88, R89: 200K; 0207/5V
R90: 200k; 0207/5V
R91, R200: 1M; 0207/5V
R95, R130, R132, R136, R152: 100; 0207/5V
R96, R97, R115: 10K; 0207/2V
R98: 2.2K; 0207/2V
R100A, R100B: THERMISTOR-7,5; R-7,5
R103, R235, R236: 220k; 0207/5V
R106: 27K; 0207/5V
R120: 22k; 0207/5V
R123: 1.5M; 0207/5V
R135: 4.7k; 0207/5V
R137: 1K; 0207/10
R138: 68K; 0207/5V
R150: 22; 0207/5V
R153: 100k; 0207/5V
R157, R158, R160: 10k; 0207/5V
R159: 33K; 0207/5V
R161: 1K; 0207/5V
R232: 10K; 0207/10
R234: 10K; 0207/15
S1: SWITCH_GND; NKKTOGGLE
S2: PEC11-S
S3, S4: GH3074
S5, S6, S7, S8, S9, S10, S11, S12, S13, S14, S15, S16, S17, S18, S19, S20, S21, S22, S23, S24, S25, S26, S27: B3F-40XX
TM3: 500K(B); 306
TM4: 50K(B); 306
TM5: 5K(B); 306
U$2, U$23, U$24, U$25, U$27, U$28, U$29: 1,3
VR2, VR7: 50K(B); EVU
VR3, VR5, VR8: 50K(A); EVU
VR4: 50K(B); ALPHADUAL
VR6: 1M(A); ALPHADUAL
XTL1: 2SC2021R; 2SC2021

Connections:
+5.333V: C31.+, IC9.1, IC9.16, IC11.3, J4.1, Q26.1, R36.2, R65.2, R66.2, R68.1, R78.1, R100A.2, R100B.1, R101.2, R116.2, R117.1, R126.1, R157.2, R162.1, TM4.3, VR2.3
+5V: C102.+, C103.1, C104.2, C106.2, C107.2, C108.2, C109.2, C110.2, C111.2, C112.2, C113.2, D1.C, IC1.1, IC1.14, IC2.3, IC2.7, IC2.8, IC3.40, IC4.10, IC4.16, IC5.10, IC5.16, IC6.10, IC6.16, IC7.10, IC7.16, IC8.10, IC8.16, IC16.16, IC17.16, IC18.16, J2.2, J3.3, J3.4, R200.1, S5.2, S6.3, S7.1, S8.1, S9.1, S10.1, S11.1, S12.4, S13.4, S14.2, S15.4, S16.4, S17.2, S18.2, S19.1, S19.2, S20.2, S21.2, S22.1, S22.2, S23.1, S23.2, S24.2, S25.4, S26.4, S27.2
+6V: C46.1, C49.+, D33.C, IC14.7, J5.3
+12V: C32.+, C72.+, D31.C, IC11.8, IC12.14, IC15A.4, IC15A.9, IC15B.9, J4.3, Q1.3, Q2.3, Q27.3, Q28.1, Q36.3, Q40.2, Q41.2, R45.1, R92.2, R93.1, R95.2, R103.1, R123.2, R136.1, R139.2, R142.2, R149.2, R150.1, TM4.1, VR3.3
ACCENT: IC3.28, R141.2
C48: C48.+, IC14.9
DINSYNC1: IC3.17, J3.12
DINSYNC2: IC3.16, J3.11
DINSYNC3: IC3.15, J3.10
DINSYNC4: IC3.14, J3.9
GATE: IC3.30, R146.2
GND: C11.-, C13.-, C16.-, C22.-, C28.-, C29.-, C30.-, C31.-, C32.-, C33.2, C35.2, C36.2, C37.-, C40.-, C41.2, C42.-, C45.2, C48.-, C49.-, C52.-, C53.-, C55.-, C62.-, C100.1, C101.1, C102.-, C103.2, C104.1, C105.-, C106.1, C107.1, C108.1, C109.1, C110.1, C111.1, C112.1, C113.1, D26.C, D30.A, D32.A, IC1.4, IC1.5, IC1.7, IC1.12, IC1.13, IC2.4, IC3.20, IC4.8, IC4.13, IC5.8, IC5.13, IC6.8, IC6.13, IC7.8, IC7.13, IC8.8, IC8.13, IC9.8, IC11.4, IC12.7, IC14.5, IC15A.5, IC15B.3, IC15B.5, IC16.8, IC16.10, IC16.15, IC17.8, IC17.15, IC18.8, IC18.15, J3.7, J3.8, J4.2, J5.2, J6.2, J7.2, LED1.K, LED2.K, LED3.K, LED4.K, LED5.K, LED6.K, LED7.K, LED8.K, LED9.K, LED10.K, LED11.K, LED12.K, LED13.K, LED14.K, LED15.K, LED16.K, LED17.K, LED18.K, LED19.K, LED20.K, LED21.K, LED22.K, LED23.K, LED24.K, LED25.K, LED26.K, LED27.K, LED28.K, LED29.K, LED30.K, LED31.K, LED32.K, LED33.K, LED34.K, LED35.K, LED36.K, LED37.K, LED38.K, LED39.K, LED40.K, Q3.3, Q4.3, Q5.3, Q9.2, Q29.3, Q30.3, Q35.3, Q37.3, Q39.2, Q39.3, R60.1, R64.2, R94.1, R96.1, R105.1, R108.1, R109.2, R130.2, R135.1, R140.2, R144.2, R145.1, R151.1, R160.1, R165.2, R201.2, R202.2, R206.2, R207.1, R209.2, R210.2, R212.2, R214.2, R216.2, R218.2, R219.2, R220.2, R224.2, R225.2, R226.2, R230.2, R231.2, R232.2, R233.2, R240.2, R247.2, R255.1, R257.2, R259.2, R263.2, S1.M1, S1.M2, S1.M3, S1.M4, S2.C, S2.P$1, S2.P$2, S3.MT1, S3.MT2, S3.MT3, S3.MT4, S4.MT1, S4.MT2, S4.MT3, S4.MT4, VR2.1, VR2.M1, VR2.M2, VR3.M1, VR3.M2, VR4.1A, VR4.M1, VR4.M2, VR5.M1, VR5.M2, VR6.1A, VR6.2A, VR6.3A, VR6.M1, VR6.M2, VR7.1, VR7.M1, VR7.M2, VR8.1, VR8.M1, VR8.M2, XTL1.2
LED_LATCH: IC3.32, IC4.12, IC5.12, IC6.12, IC7.12, IC8.12
MIDI_IN: IC3.10, J3.5
MIDI_OUT: IC3.11, J3.6
unnamed: C51.-, IC14.2
unnamed: C51.+, R159.1
unnamed: C50.+, IC14.3
unnamed: C50.-, R135.2
unnamed: Q34.3, R153.1, R155.2, R156.1
unnamed: C56.+, R161.1
unnamed: C56.-, J7.1, R165.1
unnamed: C47.1, IC14.4
unnamed: C47.2, IC14.1
unnamed: C43.-, J5.1
unnamed: C43.+, C44.-, C45.1, D32.C, D33.A, IC14.6
unnamed: Q33.2, R153.2, R159.2, R160.2, R161.2
unnamed: C44.+, C46.2, IC14.8
unnamed: Q34.2, R154.1, R158.1
unnamed: Q33.1, R158.2
unnamed: C53.+, Q33.3, R136.2, R154.2
unnamed: C52.+, Q34.1, R157.1
unnamed: C59.+, R155.1
unnamed: C58.+, R156.2
unnamed: C58.-, J7.3
unnamed: C20.1, R122.2
unnamed: C37.+, R124.2, R125.1, R126.2
unnamed: IC7.1, R252.2
unnamed: IC15A.2, IC15B.2, R125.2
unnamed: C21.1, R121.1
unnamed: C15.-, C20.2, VR4.2A
unnamed: C14.-, C21.2, VR4.3A
unnamed: IC15A.6, IC15A.7, IC15B.6, IC15B.7, R127.1, R128.2
unnamed: IC15B.4, Q1.2
unnamed: R127.2, R129.1
unnamed: C40.+, R128.1, R129.2, R162.2
unnamed: C38.-, VR8.3
unnamed: D27.A, R120.1
unnamed: C36.1, R119.1, R120.2
unnamed: D24.A, R119.2, VR7.2
unnamed: C55.+, Q38.3, R150.2
unnamed: C72.-, Q36.1, R142.1, R143.2
unnamed: D34.A, D35.A, Q36.2, R145.2
unnamed: Q38.1, R148.2, R149.1
unnamed: D37.C, R152.2
unnamed: C54.1, R148.1
unnamed: C54.2, Q37.2, R143.1
unnamed: Q37.1, R144.1, R146.1
unnamed: D36.A, D37.A, Q38.2, R151.2
unnamed: C62.+, Q40.1, R138.2, R152.1
unnamed: Q40.3, Q41.1
unnamed: C38.+, IC15A.8, IC15B.8
unnamed: R61.1, VR5.1
unnamed: D26.A, D29.C, R117.2
unnamed: D28.C, D29.A
unnamed: D28.A, IC12.4, VR6.2B, VR6.3B
unnamed: IC12.1, Q39.1, Q41.3, VR5.3
unnamed: Q35.1, R140.1, R141.1
unnamed: Q32.3, R130.1
unnamed: IC12.5, IC12.13, Q35.2, R139.1
unnamed: D34.C, R137.1
unnamed: Q5.1, R254.1, R255.2
unnamed: Q12.5, R97.1, R98.1
unnamed: D35.C, R133.2
unnamed: D36.C, R134.1
unnamed: C41.1, Q32.1, R134.2
unnamed: Q32.2, R132.2
unnamed: C42.+, Q31.1, R123.1, R132.1
unnamed: D27.C, IC15A.1, Q3.1, Q3.2, Q4.1, Q31.2
unnamed: Q31.3, R131.1
unnamed: R131.2, R133.1
unnamed: IC9.10, R90.1
unnamed: R236.1, R269.2, S2.B
unnamed: IC4.7, R241.1
unnamed: C35.1, IC12.9, IC12.10
unnamed: IC12.6, Q30.2, R93.2
unnamed: Q30.1, R91.2
unnamed: IC11.6, R107.1
unnamed: R85.2, R86.1, R87.2, R88.2, R89.1
unnamed: IC1.9, IC18.9
unnamed: IC12.12, Q29.2, R91.1, R92.1
unnamed: R79.1, R83.1, R84.2, R85.1, R86.2
unnamed: C105.+, D1.A, D2.C, IC1.2, R200.2
unnamed: IC9.15, R81.2
unnamed: IC9.2, R82.1
unnamed: IC9.12, R79.2
unnamed: Q29.1, R59.2, R60.2
unnamed: C34.1, IC11.1, R104.2
unnamed: C34.2, IC11.2, Q26.2, R102.1, R103.2
unnamed: Q26.5, R100A.1, R100B.2, R106.2, R118.2
unnamed: IC4.6, R237.1
unnamed: Q26.3, R104.1
unnamed: R118.1, VR2.2
unnamed: D25.A, Q27.2
unnamed: D25.C, Q24.1, Q24.2, Q25.1
unnamed: Q24.3, R101.1
unnamed: Q25.2, Q27.1
unnamed: IC17.5, R207.2, S12.1
unnamed: C10.1, Q28.3, R35.1, R105.2, S1.1
unnamed: Q8.1, R34.1, R35.2
unnamed: C10.2, R34.2
unnamed: IC11.5, IC12.8, R88.1, R89.2, R90.2
unnamed: C33.1, Q25.3, Q26.4, Q28.2
unnamed: R102.2, TM4.2
unnamed: C30.+, Q22.3, R115.2
unnamed: C24.1, Q14.1, Q14.2, Q16.3
unnamed: C19.1, Q13.1, Q13.2, Q14.3
unnamed: C18.2, Q12.2, Q13.3
unnamed: C24.2, Q17.1, Q17.2, Q23.3
unnamed: C26.2, C27.1, Q22.5, Q23.1, Q23.2
unnamed: C18.1, Q12.4, Q15.3
unnamed: C28.+, Q18.2, Q19.2, Q22.2, Q22.4, R95.1, R110.2, R111.1, R115.1
unnamed: C17.+, R62.2
unnamed: C17.-, Q12.1, R70.1
unnamed: C16.+, R68.2, R70.2, R98.2
unnamed: R62.1, S1.2
unnamed: Q12.3, R69.1
unnamed: C23.+, R97.2
unnamed: LED6.A, R244.1
unnamed: C23.-, Q18.3, R94.2
unnamed: Q18.1, R67.2, R99.2
unnamed: C22.+, R66.1, R99.1
unnamed: C15.+, R67.1
unnamed: Q10.1, R63.1, R71.2, R72.1
unnamed: Q20.1, R109.1, R112.2
unnamed: Q20.3, R108.2
unnamed: LED7.A, R250.1
unnamed: C25.2, Q21.1, R114.2
unnamed: Q20.2, Q21.3
unnamed: Q19.1, Q21.2, R110.1
unnamed: C27.2, Q21.5, R113.1
unnamed: R47.1, VR3.1
unnamed: C25.1, C26.1, Q16.1, Q16.2, Q22.1
unnamed: C14.+, Q19.3, R96.2
unnamed: Q11.2, R69.2
unnamed: Q10.3, Q11.1, R73.1
unnamed: Q21.4, R111.2
unnamed: Q9.1, R64.1, R65.1
unnamed: IC12.2, VR7.3
unnamed: R73.2, TM3.2, TM3.3
unnamed: R72.2, VR4.2B
unnamed: R63.2, VR5.2
unnamed: TM3.1, VR3.2
unnamed: R76.2, R77.1, R80.2, R83.2, R84.1
unnamed: IC12.3, R138.1, VR6.1B
unnamed: R106.1, TM5.1
unnamed: C59.-, VR8.2
unnamed: D24.C, R46.1
unnamed: R46.2, VR4.1B
unnamed: C13.+, VR4.3B
unnamed: R257.1, S10.4
unnamed: IC17.14, R218.1, S9.3
unnamed: IC17.13, S8.3
unnamed: IC17.12, R225.1, S7.3
unnamed: R259.1, S11.4
unnamed: IC18.14, R230.1, S5.4
unnamed: D3.C, S4.P$1
unnamed: IC18.12, R232.1, S15.1
unnamed: R206.1, S26.2
unnamed: IC16.5, S27.3
unnamed: IC17.9, IC18.10
unnamed: IC18.4, R224.1, S18.4
unnamed: IC17.4, S11.3
unnamed: D4.C, S4.P$2
unnamed: R209.1, S25.2
unnamed: IC4.5, R234.1
unnamed: IC5.9, IC7.14
unnamed: IC5.6, R243.2
unnamed: IC5.7, R244.2
unnamed: IC5.5, R242.1
unnamed: IC7.15, R250.2
unnamed: IC7.2, R251.1
unnamed: LED1.A, R234.2
unnamed: LED2.A, R237.2
unnamed: IC7.3, R253.1
unnamed: IC7.4, R256.1
unnamed: LED14.A, R262.1
unnamed: IC8.3, R264.1
unnamed: IC8.6, R267.1
unnamed: IC8.7, R268.1
unnamed: IC8.5, R266.2
unnamed: IC5.1, R223.1
unnamed: IC8.4, R265.1
unnamed: IC5.2, R222.2
unnamed: IC5.15, R221.1
unnamed: IC5.4, R246.1
unnamed: IC5.3, R245.2
unnamed: IC4.3, R238.2
unnamed: IC4.4, R239.2
unnamed: IC4.1, R229.1
unnamed: IC7.6, R261.1
unnamed: IC7.7, R262.2
unnamed: IC7.5, R260.1
unnamed: IC4.2, R228.2
unnamed: IC4.15, R227.1
unnamed: IC8.15, R203.1
unnamed: IC8.1, R205.1
unnamed: IC8.2, R204.2
unnamed: IC6.15, R208.1
unnamed: IC6.1, R211.1
unnamed: IC6.2, R213.1
unnamed: IC6.3, R215.1
unnamed: IC6.4, R217.2
unnamed: IC6.7, R248.1
unnamed: IC6.6, R249.2
unnamed: IC6.5, R258.1
unnamed: IC16.9, IC17.10
unnamed: IC16.13, R214.1, S22.4
unnamed: R210.1, S24.4
unnamed: IC16.11, S23.3
unnamed: IC16.4, S26.1
unnamed: IC18.6, R219.1, S20.4
unnamed: IC16.12, R216.1, S21.4
unnamed: R240.1, S6.2
unnamed: IC16.14, S24.3
unnamed: IC9.7, R87.1
unnamed: R201.1, S27.4
unnamed: R235.1, R270.1, S2.A
unnamed: R212.1, S23.4
unnamed: IC9.5, R80.1
unnamed: R74.2, R75.2, R78.2, R82.2
unnamed: LED9.A, R252.1
unnamed: LED10.A, R253.2
unnamed: LED11.A, R256.2
unnamed: LED12.A, R260.2
unnamed: IC18.5, R220.1, S19.4
unnamed: R74.1, R75.1, R76.1, R77.2, R81.1
unnamed: R231.1, S16.2
unnamed: IC16.6, R202.1, S14.3
unnamed: R263.1, S13.2
unnamed: Q5.2, S4.C
unnamed: IC17.6, S13.1
unnamed: IC18.3, R226.1, S17.4
unnamed: IC17.3, S10.3
unnamed: LED16.A, R267.2
unnamed: IC17.11, S6.1
unnamed: IC18.11, S16.1
unnamed: IC16.3, S25.1
unnamed: R247.1, S8.4
unnamed: LED3.A, R241.2
unnamed: LED4.A, R242.2
unnamed: LED5.A, R243.1
unnamed: LED15.A, R266.1
unnamed: LED8.A, R251.2
unnamed: LED13.A, R261.2
unnamed: IC4.9, IC5.14
unnamed: IC6.14, IC7.9
unnamed: IC6.9, IC8.14
unnamed: LED17.A, R268.2
unnamed: LED18.A, R238.1
unnamed: LED19.A, R239.1
unnamed: LED20.A, R245.1
unnamed: LED21.A, R246.2
unnamed: LED22.A, R248.2
unnamed: LED23.A, R249.1
unnamed: LED24.A, R258.2
unnamed: LED25.A, R265.2
unnamed: LED26.A, R264.2
unnamed: LED27.A, R203.2
unnamed: LED28.A, R229.2
unnamed: LED29.A, R228.1
unnamed: LED30.A, R227.2
unnamed: LED31.A, R223.2
unnamed: LED32.A, R222.1
unnamed: LED33.A, R221.2
unnamed: LED34.A, R217.1
unnamed: LED35.A, R215.2
unnamed: LED36.A, R213.2
unnamed: LED37.A, R211.2
unnamed: LED38.A, R208.2
unnamed: LED39.A, R205.2
unnamed: LED40.A, R204.1
unnamed: D2.A, IC1.3, IC3.9
unnamed: D5.C, S4.P$4
unnamed: D6.C, S4.P$8
unnamed: D7.C, S3.P$1
unnamed: D8.C, S3.P$2
unnamed: D9.C, S3.P$4
unnamed: D10.C, S3.P$8
unnamed: C11.+, Q8.3, R45.2
unnamed: Q8.2, R36.1, S1.3
unnamed: J1.1, S2.SW1
unnamed: J2.1, R269.1, R270.2, S2.SW2
unnamed: IC3.18, XTL1.3
unnamed: Q9.3, Q10.2, Q11.3, R47.2, R61.2, R71.1
unnamed: C29.+, R112.1, R113.2, R114.1, R116.1
unnamed: Q1.1, Q2.1, Q2.2, Q4.2
unnamed: J6.3, R137.2
unnamed: IC15A.3, IC15B.1, R121.2, R122.1, R124.1
unnamed: D30.C, D31.A, IC11.7, IC12.11, J6.1, R107.2, TM5.2, TM5.3
NOTE0: IC3.21, IC9.3
NOTE1: IC3.22, IC9.14
NOTE2: IC3.23, IC9.4
NOTE3: IC3.24, IC9.13
NOTE4: IC3.25, IC9.6
NOTE5: IC3.26, IC9.11
NOTE_LATCH: IC3.29, IC9.9
Q17: C19.2, Q15.1, Q15.2, Q17.3
ROTARY1: D3.A, D7.A, IC3.34
ROTARY2: D4.A, D8.A, IC3.35
ROTARY4: D5.A, D9.A, IC3.36
ROTARY8: D6.A, D10.A, IC3.37
ROTARYCOM3: IC3.33, R254.2, S3.C
SLIDE: IC3.27, R59.1
SPI_CLK: IC2.6, IC3.8, IC4.11, IC5.11, IC6.11, IC7.11, IC8.11, IC16.2, IC17.2, IC18.2
SPI_IN: IC2.5, IC3.6, IC4.14
SPI_OUT: IC1.8, IC2.2, IC3.7
SWITCH_LATCH: IC1.10, IC2.1, IC3.1, IC16.1, IC17.1, IC18.1
TEMPO_SW: IC18.13, J1.2, R233.1
TEMPO_SW_A: C100.2, IC3.38, R235.2
TEMPO_SW_B: C101.2, IC3.39, R236.2
USBRX: IC3.3, J3.1
USB_TX: IC3.4, J3.2
XTL1: IC3.19, XTL1.1
