x0xb0x/x0xb0x.github.io/(commit log)

2015-11-29 Scrape from ladyada.net/make/x0xb0x , purge menus, some whitespace cleaning
    [x0xb0x_iopanel_march2.dxf, x0xbox_mainpanel_march2.dxf]
2015-11-29 Move scripts, images, fonts and other files to assets dir
    [x0xb0x_iopanel_march2.dxf, x0xbox_mainpanel_march2.dxf]
2015-11-30 Move assets
    [x0xb0x_iopanel_march2.dxf, x0xbox_mainpanel_march2.dxf]
2016-02-27 Correction on general page subtitle, re-insert dropped referral line
2019-09-25 Add brd and sch files and adjust download page
    [ioboard.brd, ioboard.sch, mainboard.brd, mainboard.sch]
